tumo07/vehicle-dashboard-cluster/_docx_extract/word/media/image5.png

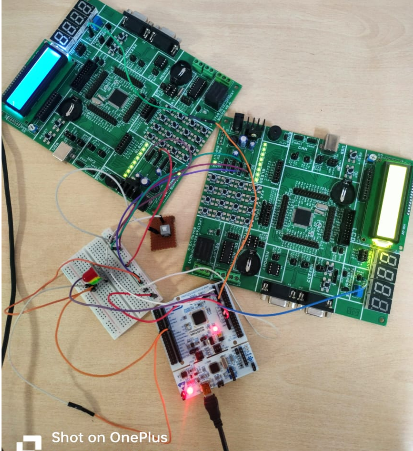
_docx_extract/word/media/image5.png
