tumo07/vehicle-dashboard-cluster/Project_CAN_Bus_Plan.docx

# Smart Vehicle Dashboard Cluster

Complete Implementation Plan (Final - Rev 3)

# 1. Project Overview

This project simulates a real automotive embedded network using the CAN Bus protocol. Four STM32 microcontrollers communicate on a shared 500 kbps CAN bus, each acting as a distinct Electronic Control Unit (ECU). A Qt desktop application serves as the digital instrument cluster (HMI), receiving all CAN traffic via a USB-Serial bridge and sending user commands back onto the bus.

This revision incorporates advanced features including Cloud Telemetry (MQTT), Database Logging (SQLite), Reverse Parking Assist (HC-SR04), and a strict MVC Software Architecture for the HMI.

The project is structured as a Monorepo segmented into 5 distinct modules, plus a shared CAN definitions folder. The team of 5 will collaborate using GitHub CODEOWNERS.

# 2. Confirmed Hardware

Component | Details
Main ECU board | STM32F4-Discovery (STM32F407VGT6)
CAN Bridge / Translator | Blue Pill (STM32F103C8T6)
Front BCM | Blue Pill (STM32F103C8T6)
Rear BCM | Blue Pill (STM32F103C8T6)
CAN Transceivers | SN65HVD230 (3.3V) — one per node
CAN Bitrate | 500 kbps (120 Ω bus termination)
PC Interface | USB-Serial adapter (CH340/CP2102)
Trunk Actuator | Servo motor (50 Hz PWM)
Reverse Sensor | HC-SR04 Ultrasonic Sensor
Speed/Fuel Sim | Potentiometers → ADC
Brake Pedal | Physical push-button (PA0)

# 3. Qt Dashboard Architecture (MVC + DB + IoT)

- Repo 1 (qt_dashboard) utilizes an advanced architecture:
- MVC Architecture: SerialManager (Service), VehicleState (Model), VehicleController (Controller), and QML UI (View).
- SQLite Trip Logging: Local DB logging for speed, fuel consumption, and safety events.
- MQTT Cloud Telemetry: Publishes dashboard data to Mosquitto/ThingSpeak for Fleet Management.

# 4. Node Responsibilities

## 4.1 Node 0x01 — STM32F4-Discovery (Main MCU)

Role: Central sensor broadcaster, blink-tick master, error aggregator.

- PA1 (ADC1 CH1): Speed potentiometer

- PA2 (ADC1 CH2): Fuel potentiometer

- PA0: Headlight toggle button

- PD12/PD13/PD14: Speed status LEDs

- Broadcasts: 0x100, 0x101, 0x102, 0x130 (Blink Tick)

## 4.2 Node 0x00 — Translator (Blue Pill)

Role: Passive bus sniffer and active command injector.

- UART TX: CAN:ID:DLC:DATA

- UART RX: CMD:ID:DLC:DATA

## 4.3 Node 0x02 — Front BCM (Blue Pill)

Role: Front body actuator control.

- PB0: Headlight, PB1: Washer, PB3: Wiper

- PB4/PB5: Front Left/Right turn signal LEDs

- Toggles turn signals on receiving 0x130 Blink Tick

## 4.4 Node 0x03 — Rear BCM (Blue Pill)

Role: Rear body actuators and Reverse Radar.

- PA6 / PA7: HC-SR04 Echo (TIM3 CH1) / Trigger

- PB0: Brake lights, PB1/PB3: Rear turn signals

- PB6: Trunk servo (TIM4 CH1 PWM)

- Transmits 0x301 (Reverse Distance)

# 5. CAN Message Table

CAN ID | Name | DLC | Data Payload
0x100 | Speed | 2 | Byte0: High, Byte1: Low (uint16)
0x101 | Fuel Level | 1 | Byte0: 0-100% (uint8)
0x102 | Headlight | 1 | Byte0: 0x00 / 0x01
0x130 | Blink Tick | 1 | Byte0: 0x01 (Sync tick)
0x110 | Front Command | 1 | Bit0: Headlight, Bit1: Washer, Bit2: Wiper, Bit3: L-Turn, Bit4: R-Turn
0x120 | Rear Command | 1 | Bit0: L-Turn, Bit1: R-Turn, Bit2: Trunk Open, Bit3: Trunk Close
0x200 | Front Status | 2 | Actuator states
0x300 | Rear Status | 2 | Actuator states + Trunk pos
0x301 | Reverse Radar | 2 | Byte0: High, Byte1: Low (Distance in cm)
0x700 | System Error | 3 | Byte0: Source Node, Byte1: Error Code, Byte2: Fault Bitmask
