tumo07/vehicle-dashboard-cluster/front_bcm_firmware/Bao_Cao_Thuyet_Trinh_Front_BCM_Nguyen_Quoc_Dat.pptx

TRƯỜNG ĐẠI HỌC FPT TP.HCM — KHOA KỸ THUẬT Ô TÔ & KHOA HỌC MÁY TÍNH
THIẾT KẾ VÀ HIỆN THỰC HÓA PHÂN HỆ FRONT BCM
Kiến trúc Vi điều khiển kép (Dual-MCU) trên nền tảng Mạng CAN Bus v3.0 Coordinator
• Sinh viên thực hiện: Nguyễn Quốc Đạt — MSSV: FMS00045 (Kỹ sư Phân hệ Front BCM)
• Đề tài: Smart Vehicle Dashboard Cluster Simulator (Nhóm 2 — Lớp M1.2510.E0)
• Giảng viên hướng dẫn: ThS. Phạm Toàn Văn Võ

## Slide 2

FRONT BCM FIRMWARE | SOFTWARE DESIGN

1. TỔNG QUAN VÀ VỊ TRÍ TRONG KIẾN TRÚC PHÂN VÙNG ZONAL E/E

VỊ TRÍ CHIẾN LƯỢC: SMART ZONAL HUB

• Xu hướng Zonal Architecture:
Chuyển dịch từ phân tán theo chức năng sang phân vùng không gian. Front BCM đặt tại khoang động cơ/đầu xe.
• Gom cụm tải & Cảm biến:
Quản lý trực tiếp hệ thống đèn pha, sương mù, DRL, mô-tơ gạt mưa, bơm nước rửa kính, cảm biến mưa quang học và chiết áp Dimmer.
• Tối ưu hóa Dây dẫn (Wiring Harness):
Thay vì kéo hàng chục dây công suất về táp-lô, chỉ duy trì 01 tuyến CAN Bus vi sai 2 dây (CAN_H, CAN_L) kết nối với Central Coordinator ECU.

YÊU CẦU KỸ THUẬT CỐT LÕI (REQUIREMENTS)

1. Thời gian thực khắt khe (Hard Real-Time):
- Độ trễ phản hồi tại biên: < 20 ms.
- Độ trễ toàn trình (End-to-End) đến HMI: < 45 ms.
2. Kháng nghẽn băng thông (Anti-Bottleneck):
- Không làm tràn bộ đệm UART (115200 bps) khi mạng CAN (500 kbps) chạy tải đỉnh.
3. An toàn chức năng (Functional Safety ISO 26262):
- Cơ chế Khóa lỗi cứng (Latched Fault) bảo vệ cháy bơm.
- Tự chẩn đoán phím kẹt vật lý sinh mã DTC chuẩn SAE J2012.

## Slide 3

FRONT BCM FIRMWARE | SOFTWARE DESIGN

2. KIẾN TRÚC PHẦN CỨNG VI ĐIỀU KHIỂN KÉP (DUAL-MCU ARCHITECTURE)

TRANSLATOR NODE — STM32F103C8T6

• Vai trò: Dedicated Gateway (Lớp mạng)
• Thông số: ARM Cortex-M3 @ 72 MHz, 64KB Flash, 20KB SRAM.
• Tác vụ đảm nhận:
- Giao tiếp trực tiếp trục CAN Bus 500 kbps qua bxCAN1.
- Bộ lọc phần cứng (Hardware ID-Mask Filter).
- Xử lý ngắt 100% (Interrupt-Driven) FIFO0 & UART.
- Thuật toán Change-Detection (Shadow Copies) lọc rác.
- Bộ giám sát Timeout 25ms chống trôi khung UART.

ACTUATOR NODE — STM32F411VET6

• Vai trò: Real-Time Actuator & Logic (Lớp ứng dụng)
• Thông số: ARM Cortex-M4F @ 96 MHz, 512KB Flash, 128KB SRAM.
• Tác vụ đảm nhận:
- Đọc ADC liên tục bằng phần cứng DMA (Mưa PA0, Dimmer PC1).
- Xuất 4 kênh PWM: Servo gạt mưa (TIM2), Bơm nước (TIM3), Pha/Cos (TIM4).
- Máy trạng thái gạt mưa 5 chế độ & An toàn bơm nước cạn.
- Chống xung đột quang học đèn và tự động bật đèn sương mù.
- Giám sát Watchdog kẹt nút cơ học > 1.5s sinh mã DTC.

## Slide 4

FRONT BCM FIRMWARE | SOFTWARE DESIGN

3. MA TRẬN BẢN TIN CAN BUS V3.0 CỦA PHÂN HỆ FRONT BCM

Tên Định Danh CAN | CAN ID | Hướng Truyền | DLC | Ý Nghĩa Tải Dữ Liệu (Payload Specification)
CAN_ID_EXEC_FRONT_LIGHTS | 0x200 | Central -> Front | 2 | Byte0: Bitmask đèn (DRL/Cos/Pha/Fog) | Byte1: Độ sáng PWM 0-100%
CAN_ID_EXEC_FRONT_WIPERS | 0x201 | Central -> Front | 2 | Byte0: CmdWiper_t (OFF/INT/SLOW/NORM/FAST/AUTO) | Byte1: Bơm nước
CAN_ID_EXEC_FRONT_TURN | 0x202 | Central -> Front | 1 | Byte0: Bitmask vũ trang xi-nhan trước (Trái, Phải, Hazard)
CAN_ID_BLINK_TICK | 0x130 | Central -> All | 1 | Byte0: 0x01 — Nhịp đồng hồ chớp 1 Hz toàn cục phát mỗi 500 ms
CAN_ID_REPORT_FRONT_STATUS | 0x400 | Front -> Central | 3 | Byte0: FrontActuatorFlags_t | Byte1: WiperMode | Byte2: Health mô-tơ
CAN_ID_REPORT_FRONT_SENSORS | 0x401 | Front -> Central | 2 | Byte0: Cảm biến mưa % (ADC) | Byte1: Mức nước rửa kính % (Phao PE9)
CAN_ID_FAULT_FRONT_BCM | 0x500 | Front -> Central | 5 | Byte0: Severity | Byte1-2: Mã DTC 16-bit | Byte3: Counter | Byte4: ErrCode

## Slide 5

FRONT BCM FIRMWARE | SOFTWARE DESIGN

4. GIAO THỨC UART NỘI BỘ & GIẢI THUẬT CHỐNG TRÔI KHUNG (ANTI-DESYNC)

CẤU TRÚC KHUNG TRUYỀN ĐỒNG BỘ 5-BYTE

• Định dạng khung (F103 -> F411):
[0xAA] [CMD_ID] [DATA_0] [DATA_1] [CHECKSUM]
• Thuật toán Checksum tuyến tính:
Checksum = (uint8_t)(CMD_ID + DATA_0 + DATA_1);
Gói tin sai lệch Checksum bị hủy ngay tại tầng ngắt.
• Phân loại lệnh điều khiển:
- 0x01: Điều khiển đèn (Mask + Brightness)
- 0x02: Gạt mưa & Rửa kính (Mode + Washer)
- 0x03: Xi-nhan vũ trang (Turn Arm)
- 0x04: Nhịp đồng hồ chớp Blink Tick (0x130)

GIẢI THUẬT TIMEOUT 25MS CHỐNG TRÔI KHUNG

• Vấn đề kinh điển của UART: Desynchronization
Nếu mất 1 byte do nhiễu, các gói tin tiếp theo sẽ bị xô lệch vĩnh viễn do MCU lấy nhầm Data làm Start Byte.
• Giải pháp: Inter-Byte Software Watchdog 25ms
uint32_t current_time = HAL_GetTick();
if (current_time - last_rx_time > 25) {
rx_index = 0; // Tự động Reset bộ đệm
}
last_rx_time = current_time;
• Tự giải phóng lỗi phần cứng Overrun:
if (__HAL_UART_GET_FLAG(pUart, UART_FLAG_ORE)) {
__HAL_UART_CLEAR_OREFLAG(pUart);
}

## Slide 6

FRONT BCM FIRMWARE | SOFTWARE DESIGN

5. TRANSLATOR NODE (F103) — THUẬT TOÁN CHANGE-DETECTION (SHADOW COPIES)

BÀI TOÁN NGHẼN CỔ CHAI BĂNG THÔNG

• Xung đột tốc độ truyền dẫn:
- Mạng CAN Bus xe: 500 kbps.
- Đường truyền UART nội bộ: 115200 bps.
• Rủi ro nghẽn mạch (Bus Overrun):
Central ECU phát chu kỳ liên tục các lệnh điều khiển (kể cả khi không có thay đổi). Nếu F103 đẩy mù quáng xuống UART, bộ đệm F411 sẽ bị nghẽn và tràn dữ liệu lập tức.
• Đích đến giải thuật:
Chỉ chuyển tiếp xuống F411 khi và chỉ khi có sự thay đổi trạng thái (Delta Change Only)!

HIỆN THỰC THUẬT TOÁN BẰNG SHADOW COPIES

/* Code thực tế trong file RX_data_CAN.c */
static uint8_t prev_light_mask = 0xFF;
static uint8_t prev_light_brightness = 0xFF;
static void Forward_If_Changed(uint8_t cmdId,
uint8_t d0, uint8_t d1, uint8_t *prev0, uint8_t *prev1) {
// So sánh dữ liệu mới với bản sao bóng
if (d0 == *prev0 && d1 == *prev1) return; // BỎ QUA
*prev0 = d0; *prev1 = d1; // Cập nhật Shadow copy
uint8_t pkt[5] = {0xAA, cmdId, d0, d1, cks};
HAL_UART_Transmit(&huart1, pkt, 5, 10);
}
-> Giảm > 80% tải giao tiếp UART khi xe chạy ổn định!

## Slide 7

FRONT BCM FIRMWARE | SOFTWARE DESIGN

6. ACTUATOR NODE (F411) — HỆ THỐNG GẠT MƯA & KHÓA LỖI LATCHED FAULT

ĐIỀU KHIỂN GẠT MƯA TỰ ĐỘNG THÍCH ỨNG

• 5 Chế độ gạt nước (wiper.c):
OFF, INTERMITTENT (INT), SLOW, NORMAL, FAST, AUTO.
• Đọc ADC Cảm biến mưa ngầm định bằng DMA:
DMA2 Stream0 tự động cập nhật PA0 vào RAM không tốn chu kỳ CPU.
• Thuật toán trễ phân cấp (Hysteresis AUTO Mode):
- ADC > 3000: Trời khô -> Dừng gạt (1000 µs)
- 2400 - 3000: Mưa nhỏ (30%) -> Quét chậm (1800ms)
- 1800 - 2400: Mưa vừa (60%) -> Quét vừa (1200ms)
- ADC <= 1800: Mưa to (100%) -> Quét liên tục (600ms)

CƠ CHẾ KHÓA LỖI CỨNG BẢO VỆ BƠM (DTC B1012)

• Nguy cơ kỹ thuật:
Mô-tơ bơm nước rửa kính dễ cháy hỏng cuộn dây nếu chạy cạn không tải.
• Lọc nhiễu sóng nước Debounce 300ms:
Loại trừ báo động giả khi xe dằn xóc làm rung phao PE9.
• Triết lý An toàn chức năng Non-Recoverable:
- Khi xác nhận cạn nước: Bật is_water_fault_latched = 1.
- Dập tắt xung PWM bơm nước (TIM3_CH1 = 0) ngay lập tức.
- Phát mã chẩn đoán DTC_B1012 lên Central ECU.
- Bơm bị KHÓA CỨNG VĨNH VIỄN trong RAM cho đến khi kỹ thuật viên ngắt nguồn / Reset vi điều khiển!

## Slide 8

FRONT BCM FIRMWARE | SOFTWARE DESIGN

7. ACTUATOR NODE (F411) — HỆ THỐNG ĐÈN & AN TOÀN QUANG HỌC

ĐIỀU BIẾN ĐỘ SÁNG PWM & SÀN BẢO VỆ

• Điều khiển độ sáng Đèn pha (Dimmer):
- Đọc điện áp chiết áp PC1 qua kênh ADC1_IN11 (Rank 2 DMA).
- Xuất PWM tần số cao (1 kHz) trên Timer 4 CH2 (PB7) và CH3 (PB8).
• Thuật toán Giới hạn Sàn an toàn (20% Minimum Floor):
uint8_t pct = (uint8_t)((raw * 100) / 4095);
if (pct < 20) pct = 20; // Chống tắt lịm
Ngăn chặn việc vô tình vặn biến trở về 0 làm tắt ngấm đèn pha trong đêm gây nguy hiểm cho xe.

TRIỆT TIÊU ĐIỂM MÙ & AUTO FOG OVERRIDE

1. Quy tắc Triệt tiêu Điểm mù (Blind-Spot Mitigation):
Theo tiêu chuẩn chiếu sáng an toàn xe cơ giới, khi bật Pha (High Beam), đèn Cos (Low Beam) bắt buộc phải sáng đồng thời để giữ vùng sáng sát đầu xe:
if (is_high_beam_selected) {
is_pha_active = 1;
is_cos_active = 1; // BẮT BUỘC GIỮ COS SÁNG!
}
2. Tự động kích hoạt Đèn sương mù (Auto Fog Override):
Khi cảm biến mưa ghi nhận lượng mưa > 0%:
if (Get_RainSensor_Percent() > 0) is_fog_on = 1;
Hệ thống tự động bật đèn gầm PE12 hỗ trợ người lái trong thời tiết xấu.

## Slide 9

FRONT BCM FIRMWARE | SOFTWARE DESIGN

8. HỆ THỐNG TỰ CHẨN ĐOÁN KẸT PHÍM VẬT LÝ & BÁO CÁO MÃ LỖI DTC

Chân GPIO Giám Sát | Sự Cố Kẹt Cơ Học / Chập GND | Mã DTC (SAE J2012) | Mức Nghiêm Trọng | Mã Lỗi Thu Gọn
PB0 (BTN_TurnLeft) | Kẹt công tắc xi-nhan Trái > 1.5s | DTC_B1030 (0x1030) | DTC_SEVERITY_ERROR | ERR_ACTUATOR_STALL (0x05)
PB1 (BTN_TurnRight) | Kẹt công tắc xi-nhan Phải > 1.5s | DTC_B1031 (0x1031) | DTC_SEVERITY_ERROR | ERR_ACTUATOR_STALL (0x05)
GPIOE (BTN_WiperMode) | Kẹt công tắc đổi chế độ gạt nước > 1.5s | DTC_B1010 (0x1010) | DTC_SEVERITY_ERROR | ERR_WIPER_STALL (0x06)
GPIOE (BTN_CosLamp) | Kẹt công tắc đèn chiếu gần > 1.5s | DTC_B1001 (0x1001) | DTC_SEVERITY_ERROR | ERR_ACTUATOR_STALL (0x05)
GPIOE (BTN_HeadLamp) | Kẹt công tắc đèn chiếu xa > 1.5s | DTC_B1002 (0x1002) | DTC_SEVERITY_ERROR | ERR_ACTUATOR_STALL (0x05)
GPIOE (BTN_FogLamp) | Kẹt công tắc đèn sương mù > 1.5s | DTC_B1004 (0x1004) | DTC_SEVERITY_ERROR | ERR_ACTUATOR_STALL (0x05)

## Slide 10

FRONT BCM FIRMWARE | SOFTWARE DESIGN

9. KẾT QUẢ ĐO KIỂM THỰC NGHIỆM VÀ ĐÁNH GIÁ CHỈ SỐ KỸ THUẬT

ĐỘ TRỄ PHẢN HỒI BIÊN

• Kết quả đo Logic Analyzer:
1. Lọc chống rung phím: 30.0 ms
2. Đóng gói UART F411: 0.43 ms
3. Định tuyến F103: 0.12 ms
4. Chiếm bus CAN: 0.26 ms
-> ĐỘ TRỄ TẠI BIÊN: 30.81 ms
-> ĐỘ TRỄ TOÀN TRÌNH: 33.8 ms
Vượt xa ngưỡng tiêu chuẩn ô tô (< 45 ms)!

KIỂM THỬ TIÊM LỖI (FAULT INJECTION)

• Thử nghiệm 1: Cạn nước rửa kính
Rút phao PE9 -> Đúng 300ms sau dập tắt PWM bơm về 0, phát DTC B1012, bơm khóa cứng chính xác 100%.
• Thử nghiệm 2: Nhiễu đứt cáp UART
Ngắt cáp 100ms -> Cơ chế Timeout 25ms tự xóa byte rác, khôi phục đồng bộ hoàn hảo.
• Thử nghiệm 3: Kẹt phím đèn
Đè nút > 1.5s -> Sáng LED lỗi PE7, bắn CAN 0x500 phát sinh Banner đỏ trên Qt Dashboard.

TÀI NGUYÊN & TẢI CPU

• Translator Node (F103):
- Flash: 14.2 KB (22.1%)
- SRAM: 2.8 KB (14.0%)
- Tải CPU: < 4.5% (Ngắt 100%)
• Actuator Node (F411):
- Flash: 28.6 KB (5.5%)
- SRAM: 6.4 KB (5.0%)
- Tải CPU: < 8.2% (DMA hỗ trợ)
-> Hệ thống hoạt động mát mẻ, ổn định liên tục sau 100,000 khung truyền không rớt gói!

## Slide 11

FRONT BCM FIRMWARE | SOFTWARE DESIGN

10. KẾT LUẬN ĐÓNG GÓP KỸ THUẬT CỦA PHÂN HỆ FRONT BCM

ĐÓNG GÓP CỐT LÕI CỦA KỸ SƯ NGUYỄN QUỐC ĐẠT

1. Kiến trúc Dual-MCU cách ly an toàn:
Tách biệt lớp mạng CAN tốc độ cao và lớp chấp hành phần cứng, loại trừ rủi ro sập bus CAN do xung ngược.
2. Sáng tạo giải thuật Change-Detection:
Dùng Shadow Copies triệt tiêu > 80% tải giao tiếp UART dư thừa.
3. Thiết kế giao thức UART tự phục hồi (Self-Healing):
Khắc phục hoàn toàn lỗi trôi khung với Timeout 25ms và giải phóng cờ tràn ORE.
4. Hiện thực hóa chuẩn an toàn ô tô (Functional Safety):
Khóa lỗi cứng Latched Fault cạn nước (DTC B1012), triệt tiêu điểm mù Pha/Cos, tự chẩn đoán kẹt nút chuẩn SAE J2012.

HƯỚNG PHÁT TRIỂN & LỜI CẢM ƠN

• Hướng phát triển nâng cao:
- Chuyển đổi sang kiến trúc AUTOSAR Classic (tách tầng MCAL, BSW, RTE, SWC).
- Nâng cấp mạng CAN-FD (5 Mbps, 64-byte payload) phục vụ tích hợp Radar mmWave.
━━━━━━━━━━━━━━━━━━━━━━━━━━━━━
XIN TRÂN TRỌNG CẢM ƠN QUÝ THẦY CÔ TRONG HỘI ĐỒNG BẢO VỆ ĐÃ LẮNG NGHE!
RẤT MONG NHẬN ĐƯỢC NHẬN XÉT VÀ CÂU HỎI TỪ HỘI ĐỒNG (Q&A).
