tumo07/vehicle-dashboard-cluster/front_bcm_firmware/Tai_Lieu_Thiet_Ke_Firmware_Front_BCM_Nguyen_Quoc_Dat.docx

BỘ GIÁO DỤC VÀ ĐÀO TẠO — TRƯỜNG ĐẠI HỌC FPT TP.HCM
KHOA KỸ THUẬT Ô TÔ & KHOA HỌC MÁY TÍNH
BỘ MÔN HỆ THỐNG NHÚNG Ô TÔ (AUTOMOTIVE EMBEDDED SYSTEMS)

━━━━━━━━━━━━━━━━━━━━━━━━━━━━━━━━━━━━━━━━━━━━━

TÀI LIỆU THIẾT KẾ KỸ THUẬT VÀ HIỆN THỰC HÓA FIRMWARE
(SOFTWARE & FIRMWARE DESIGN SPECIFICATION - SDS)

PHÂN HỆ HỘP ĐIỀU KHIỂN THÂN XE PHÍA TRƯỚC (FRONT BCM FIRMWARE)
KIẾN TRÚC VI ĐIỀU KHIỂN KÉP DUAL-MCU (STM32F103 GATEWAY & STM32F411 ACTUATOR)
TRÊN NỀN TẢNG CAN BUS V3.0 COORDINATOR ARCHITECTURE

Dự án tốt nghiệp: | Smart Vehicle Dashboard Cluster Simulator (Mạng CAN v3.0 Coordinator)
Kỹ sư phụ trách Phân hệ Front BCM: | Nguyễn Quốc Đạt — MSSV: FMS00045
Thành viên nhóm dự án (Nhóm 2): | Trịnh Đăng Khoa (SE203770), Nguyễn Đăng Cao Huy (FMS00041), Lê Công Tiểu Long (FMS00049), Nguyễn Phương Duy Thắng (FMS00038)
Giảng viên hướng dẫn: | ThS. Phạm Toàn Văn Võ
Phiên bản tài liệu & Thời gian: | Version 3.2 (Comprehensive Monograph) — Tháng 09/2026

# TÓM TẮT THIẾT KẾ KỸ THUẬT (EXECUTIVE TECHNICAL SUMMARY)

Tài liệu này trình bày toàn diện và chi tiết bản thiết kế kỹ thuật, cấu trúc mã nguồn và thuật toán hiện thực hóa phân hệ Hộp điều khiển thân xe phía trước (Front Body Control Module - Front BCM), thuộc hệ thống 'Mạng điều phối đa vùng và Bảng đồng hồ kỹ thuật số cho ô tô thông minh' (Smart Vehicle Dashboard Cluster). Nhằm đáp ứng yêu cầu khắt khe về tính an toàn chức năng (Functional Safety) và độ trễ phản hồi thời gian thực ngặt nghèo (Hard Real-Time < 45 ms), Front BCM được kiến trúc hóa theo mô hình Vi điều khiển kép (Dual-MCU Heterogeneous Architecture) phân tách giữa tầng giao thức mạng và tầng điều khiển vật lý:

1. Translator Node (STM32F103C8T6): Đóng vai trò là Gateway thông minh kết nối trực tiếp với trục mạng CAN 2.0B tốc độ cao (500 kbps). Node này thực thi thuật toán lọc phần cứng (Hardware ID-Mask Filter), máy trạng thái ngắt hướng sự kiện 100% (Interrupt-Driven), giải thuật Change-Detection với các biến sao lưu (Shadow Copies) triệt tiêu 80% tải giao tiếp dư thừa, và cơ chế Timeout 25ms chống trôi khung truyền UART.

2. Actuator & Logic Node (STM32F411VET6): Đóng vai trò là bộ não điều khiển tải vật lý và cảm biến ngoại vi. Vi điều khiển này vận hành mô hình đa nhiệm chia sẻ rãnh thời gian (Time-Slicing Non-blocking Cooperative Scheduling), kết hợp DMA quét liên tục kênh ADC (PA0 - Cảm biến mưa, PC1 - Chiết áp Dimmer), máy trạng thái điều khiển gạt mưa 5 chế độ, cơ chế khóa lỗi cứng (Latched Fault) bảo vệ động cơ bơm nước cạn (DTC B1012), logic chống xung đột quang học đèn Pha/Cos, và bộ giám sát thời gian kẹt phím bấm cơ học (Software Watchdog > 1.5s sinh mã DTC SAE J2012).

📌 MỤC TIÊU TÀI LIỆU Tài liệu này được biên soạn độc lập cho phân hệ front_bcm_firmware, đóng vai trò là hồ sơ thiết kế kỹ thuật thành phần đối chiếu trực tiếp với các file mã nguồn: main.c, TX/RX_data_CAN.c, TX/RX_data_UART.c, read_TX_data_CAN.c (trên F103) và main_2.c, wiper.c, headlight.c, turnsignal.c, TX/RX_data_UART_2.c (trên F411).

# CHƯƠNG 1: TỔNG QUAN VÀ YÊU CẦU KỸ THUẬT PHÂN HỆ FRONT BCM

## 1.1. Vị trí của Front BCM trong Kiến trúc Phân vùng Zonal E/E

Trong xu hướng phát triển hiện đại của công nghiệp ô tô, kiến trúc Điện - Điện tử (E/E Architecture) đang chuyển dịch mạnh mẽ từ mô hình phân tán theo chức năng (Domain Architecture) sang mô hình phân vùng không gian (Spatial Zonal Architecture). Thay vì đi dây hàng trăm mét từ khoang lái đến từng bóng đèn, động cơ gạt mưa hay cảm biến đầu xe, phân hệ Front BCM được bố trí tại khoang động cơ/đầu xe như một 'Smart Zonal Hub' tập trung. Phân hệ này trực tiếp quản lý toàn bộ các tải công suất và cảm biến phía trước, chỉ duy trì duy nhất một tuyến cáp CAN Bus vi sai 2 dây (CAN_H, CAN_L) và đường nguồn để kết nối về Hộp điều phối trung tâm (Central Coordinator ECU).

## 1.2. Phân tích Yêu cầu Kỹ thuật (Requirements Engineering)

a. Yêu cầu chức năng (Functional Requirements - FR):
Phân hệ Front BCM phải đáp ứng đầy đủ các chức năng vận hành của một xe thương mại hiện đại:

• FR-01 (Chiếu sáng đa chế độ): Điều khiển độc lập và chống xung đột cụm đèn chiếu sáng gồm Đèn chạy ban ngày (DRL), Đèn chiếu gần (Cos / Low Beam), Đèn chiếu xa (Pha / High Beam) và Đèn sương mù (Fog Lamp).
• FR-02 (Tùy biến độ sáng Dimmer): Hỗ trợ điều chỉnh tuyến tính độ sáng đèn pha từ 20% đến 100% thông qua tín hiệu điều biến độ rộng xung PWM tần số cao.
• FR-03 (Gạt mưa đa cấp độ & Tự động thích ứng): Hỗ trợ 5 chế độ gạt: Tắt (OFF), Gián đoạn (INTERMITTENT), Chậm (SLOW), Nhanh (NORMAL), Cực nhanh (FAST) và Tự động (AUTO) điều tốc dựa trên lượng mưa thực tế.
• FR-04 (Bơm nước rửa kính an toàn): Tự động phun ngắt quãng khi kích hoạt chế độ INT; phát hiện cạn nước và kích hoạt cơ chế khóa bảo vệ máy bơm.
• FR-05 (Tín hiệu chuyển hướng & Khẩn cấp): Điều khiển chớp đèn xi-nhan Trái, Phải và Đèn báo nguy Hazard, hỗ trợ đồng bộ nhịp chớp từ xung đồng hồ toàn cục.
• FR-06 (Tự chẩn đoán lỗi phần cứng & DTC): Tự động phát hiện lỗi hở mạch, chập mass, kẹt nút bấm vật lý và báo cáo mã lỗi chẩn đoán tiêu chuẩn SAE J2012 / ISO 14229 lên mạng CAN.

b. Yêu cầu phi chức năng (Non-Functional Requirements - NFR):
Để đảm bảo an toàn tuyệt đối trong môi trường khắc nghiệt của ô tô:

• NFR-01 (Thời gian thực ngặt nghèo - Hard Real-Time): Thời gian từ lúc nhận lệnh CAN (hoặc nút bấm biên) đến khi tải vật lý phản hồi phải < 20 ms. Thời gian trễ toàn trình đến màn hình HMI < 45 ms.
• NFR-02 (Chống nghẽn đường truyền - Anti-Bottleneck): Không làm tràn bộ đệm UART (115200 bps) khi mạng CAN (500 kbps) hoạt động ở tải đỉnh.
• NFR-03 (Kháng nhiễu điện từ - EMI / EMC Robustness): Tự khôi phục đồng bộ khung truyền khi đường truyền nối tiếp bị rớt byte hoặc xuất hiện xung nhiễu điện thế lớn từ cuộn cảm rơ-le/mô-tơ.
• NFR-04 (Nguyên lý An toàn Chức năng - Fail-Safe ISO 26262): Không được tự ý xóa lỗi nguy hiểm (Non-recoverable Latch Fault) cho đến khi hệ thống được ngắt nguồn/khởi động lại an toàn.

## 1.3. Cơ sở Khoa học Lựa chọn Kiến trúc Vi điều khiển kép (Dual-MCU Rationale)

Một câu hỏi quan trọng trong thiết kế hệ thống nhúng ô tô: Tại sao không dùng một vi điều khiển STM32 duy nhất để điều khiển cả CAN lẫn phần cứng? Thực tế phân tích hiệu năng chứng minh giải pháp đơn vi điều khiển tiềm ẩn các rủi ro chết người:

1. Tranh chấp tài nguyên ngắt (Interrupt Jitter): Bộ điều khiển CAN yêu cầu phản hồi ngắt FIFO ở mức ưu tiên cao nhất để tránh tràn Mailbox. Nếu MCU đang bận phục vụ các hàm trễ đo đạc cảm biến, quét phím hoặc điều biến xung PWM cho Servo gạt mưa, ngắt CAN sẽ bị trễ, dẫn đến rớt gói tin điều khiển từ Central ECU.
2. Nhiễu phần cứng làm treo hệ thống mạng: Các tải công suất lớn như mô-tơ gạt nước, bơm rửa kính sinh ra tia lửa điện và nhiễu sóng ngược (Back-EMF). Nếu vi điều khiển điều khiển tải bị Reset do sụt áp hoặc nhiễu, toàn bộ kết nối CAN trên bus có thể bị kéo sập (Bus-Off). Bằng cách tách riêng STM32F103 làm Gateway cách ly, bus CAN của xe luôn được bảo vệ an toàn tuyệt đối, duy trì nhịp tim Heartbeat liên tục kể cả khi mạch chấp hành F411 gặp sự cố.

# CHƯƠNG 2: THIẾT KẾ PHẦN CỨNG VÀ PHÂN BỔ NGOẠI VI CHI TIẾT

## 2.1. Phân bổ Chân & Ngoại vi trên Translator Node (STM32F103C8T6)

STM32F103 vận hành ở xung nhịp 72 MHz (thạch anh ngoài HSE 8MHz qua nhân tần PLL x9). Toàn bộ chân kết nối được tối ưu hóa cho tác vụ cầu nối:

Chân MCU | Ngoại vi / Chức năng | Chế độ cấu hình | Mục đích sử dụng trong Firmware
PA11, PA12 | bxCAN1 (Rx, Tx) | AF_PP, 500 kbps | Kết nối Transceiver SN65HVD230 / TJA1050 giao tiếp mạng CAN Bus xe
PA9, PA10 | USART1 (Tx, Rx) | Mode TX_RX, 115200 bps | Giao tiếp kênh điều khiển 5-byte đồng bộ với bo mạch chấp hành STM32F411
PA2, PA3 | USART2 (Tx, Rx) | Mode TX_RX, 115200 bps | Cổng xuất Log Telemetry chẩn đoán lên máy tính phục vụ can_monitor.py
PD0, PD1 | OSC_IN, OSC_OUT | HSE Crystal (8.0 MHz) | Cung cấp nguồn xung nhịp ổn định cho bộ đếm thời gian baudrate CAN
PA13, PA14 | SWDIO, SWCLK | Debug SWD | Nạp firmware và gỡ lỗi thời gian thực bằng ST-Link v2

## 2.2. Phân bổ Chân & Ngoại vi trên Actuator Node (STM32F411VET6)

STM32F411 Cortex-M4 vận hành ở xung nhịp 96 MHz (HSI qua PLL). Bảng sơ đồ kết nối phần cứng thực tế (trích xuất từ main.h):

Chân MCU | Ngoại vi / Timer | Chế độ I/O | Đối tượng Phần cứng Điều khiển / Giám sát
PA0 | ADC1_IN0 (Rank 1) | Analog Input (DMA) | Cảm biến mưa quang học (Rain Sensor) - Đo điện áp analog 0 - 3.3V
PC1 | ADC1_IN11 (Rank 2) | Analog Input (DMA) | Biến trở xoay Dimmer - Điều chỉnh độ sáng đèn từ 20% đến 100%
PA1 | TIM2_CH2 (16-bit) | PWM Output (50 Hz) | Động cơ Servo SG90 mô phỏng cơ cấu tay đòn gạt mưa (1000 - 2000 µs)
PC6 | TIM3_CH1 (16-bit) | PWM Output (1 kHz) | Mạch điều khiển MOSFET đóng ngắt mô-tơ Bơm nước rửa kính chắn gió
PB7 | TIM4_CH2 (16-bit) | PWM Output (1 kHz) | Cụm đèn chiếu gần (Cos / Low Beam Lamp) - Điều tốc PWM
PB8 | TIM4_CH3 (16-bit) | PWM Output (1 kHz) | Cụm đèn chiếu xa (Pha / High Beam Lamp) - Điều tốc PWM
PE11, PE12 | GPIO Port E | Output Push-Pull | PE11: Đèn ban ngày (LED DRL); PE12: Đèn sương mù (LED Fog Lamp)
PC4, PC5 | GPIO Port C | Output Push-Pull | PC4: Đèn xi-nhan Trái (LED Signal Left); PC5: Đèn xi-nhan Phải
PE7, PE10 | GPIO Port E | Output Push-Pull | PE7: LED báo sự cố lỗi DTC; PE10: LED báo cạn nước rửa kính
PE9 | GPIO Port E | Input Floating | Cảm biến tiếp điểm phao nước rửa kính (Sensor_WaterLevel_Pin)
PB0, PB1, PB2 | GPIO Port B | Input Pull-Up | PB0: Nút Xi-nhan Trái; PB1: Nút Xi-nhan Phải; PB2: Nút báo nguy Hazard
PE8 | GPIO Port E | Input Pull-Up | Nút bấm luân chuyển chế độ gạt mưa (BTN_WiperMode_Pin)
PE13, 14, 15 | GPIO Port E | Input Pull-Up | PE13: Chuyển Pha/Cos; PE14: Nguồn đèn chính; PE15: Nút bật/tắt đèn Fog

# CHƯƠNG 3: THIẾT KẾ MA TRẬN GIAO THỨC TRUYỀN THÔNG (CAN & UART)

## 3.1. Ma trận Bản tin CAN Bus v3.0 của Front BCM

Theo can_messages.h, Front BCM tham gia trực tiếp vào 4 nhóm bản tin trọng yếu trên bus CAN:

Tên Bản Tin | CAN ID | Hướng Truyền | DLC | Cấu trúc Payload & Định nghĩa Bitmask
CAN_ID_EXEC_FRONT_LIGHTS | 0x200 | Central -> Front | 2 | Byte0: Bitmask đèn (bit0: DRL, bit1: Cos, bit2: Pha, bit3: Fog) Byte1: Độ sáng điều khiển (0 - 100%)
CAN_ID_EXEC_FRONT_WIPERS | 0x201 | Central -> Front | 2 | Byte0: CmdWiper_t (0: OFF, 1: INT, 2: SLOW, 3: NORM, 4: FAST, 5: AUTO) Byte1: Cờ kích bơm rửa kính (0x01 = Spray)
CAN_ID_EXEC_FRONT_TURN | 0x202 | Central -> Front | 1 | Byte0: Bitmask vũ trang xi-nhan (bit0: Trái, bit1: Phải, bit2: Hazard)
CAN_ID_BLINK_TICK | 0x130 | Central -> All | 1 | Byte0: 0x01 - Xung nhịp đồng hồ chớp 1 Hz toàn cục phát mỗi 500 ms
CAN_ID_REPORT_FRONT_STATUS | 0x400 | Front -> Central | 3 | Byte0: FrontActuatorFlags_t (Bitmask thực tế của DRL, Cos, Pha, Fog, Wiper, Turn) Byte1: Chế độ gạt hiện tại Byte2: Sức khỏe mô-tơ gạt (100%)
CAN_ID_REPORT_FRONT_SENSORS | 0x401 | Front -> Central | 2 | Byte0: Mức độ mưa (0 - 100% trích xuất từ ADC PA0) Byte1: Mức nước rửa kính (0% hoặc 80% từ phao PE9)
CAN_ID_FAULT_FRONT_BCM | 0x500 | Front -> Central | 5 | Byte0: DTC_Severity_t (INFO, WARN, ERR, CRIT) Byte1-2: Mã DTC 16-bit Big-Endian (vd: 0x1012) Byte3: Bộ đếm số lần lỗi Byte4: SimpleErrorCode_t

## 3.2. Thiết kế Giao thức Khung truyền UART Nội bộ (F103 ↔ F411)

Để liên kết hai vi điều khiển một cách tin cậy qua đường truyền bất đối xứng, nhóm thiết kế đã xây dựng giao thức truyền thông nhị phân với cấu trúc cố định 5-byte cho chiều Điều khiển (F103 -> F411) và cấu trúc phân loại theo Header cho chiều Báo cáo (F411 -> F103):

Hình 3.1: Cấu trúc khung truyền UART đồng bộ 5-byte từ F103 xuống F411

+------------+------------+------------+------------+------------+
| Byte 0 | Byte 1 | Byte 2 | Byte 3 | Byte 4 |
| START_OF_F | CMD_ID | DATA_0 | DATA_1 | CHECKSUM |
| 0xAA | 0x01..0x04 | Tham số 1 | Tham số 2 | 8-bit Sum |
+------------+------------+------------+------------+------------+
Thuật toán Checksum kiểm tra tính toàn vẹn:
Checksum = (uint8_t)(CMD_ID + DATA_0 + DATA_1);
Điều kiện chấp nhận khung: (rxPacket[4] == (uint8_t)(rxPacket[1] + rxPacket[2] + rxPacket[3]))

Bảng mã lệnh điều khiển:
Quy định mã lệnh Command ID (F103 -> F411):

• Lệnh 0x01 (Đèn chiếu sáng): DATA_0 = rx_cmd_light_mask; DATA_1 = rx_cmd_light_brightness.
• Lệnh 0x02 (Gạt mưa & Rửa kính): DATA_0 = rx_cmd_wiper_mode; DATA_1 = rx_cmd_wiper_washer.
• Lệnh 0x03 (Xi-nhan / Hazard): DATA_0 = rx_cmd_turn_arm; DATA_1 = 0x00.
• Lệnh 0x04 (Xung nhịp Blink Tick): DATA_0 = rx_cmd_blink_tick; DATA_1 = 0x00.

Bảng khung tin báo cáo trạng thái:
Quy định cấu trúc báo cáo phản hồi (F411 -> F103):

• Header 0x71 (Heartbeat - 3 bytes): [0x71] [Counter] [HeartbeatFlags] -> Bắn lên CAN ID 0x710.
• Header 0x40 (Status định kỳ - 4 bytes): [0x40] [ActuatorFlags] [WiperMode] [Health] -> Bắn lên CAN ID 0x400.
• Header 0x41 (Sensors định kỳ - 3 bytes): [0x41] [RainPercent] [WaterPercent] -> Bắn lên CAN ID 0x401.
• Header 0xEE (Sự cố DTC - 6 bytes): [0xEE] [Severity] [DTC_Hi] [DTC_Lo] [Counter] [ErrCode] -> Bắn lên CAN ID 0x500.
• Header 0x55 (Sự kiện Nút bấm tức thì - 4 bytes): [0x55] [WiperMode] [TurnMode] [Checksum] -> Kích hoạt truyền CAN 0x400 ngay lập tức mà không chờ chu kỳ định kỳ.

# CHƯƠNG 4: THIẾT KẾ VÀ HIỆN THỰC FIRMWARE TRANSLATOR NODE (STM32F103)

## 4.1. Kiến trúc Hướng sự kiện 100% (Interrupt-Driven Architecture)

Trong phiên bản hoàn thiện nhất (trích từ main_3.c), Translator Node đã loại bỏ hoàn toàn việc gọi hàm quét vòng lặp `TX_UART_Forward_Commands()` trong super-loop `while(1)`. Toàn bộ tiến trình chuyển đổi bản tin được đẩy trực tiếp vào các vector ngắt phần cứng: Ngắt CAN FIFO0 Pending Callback và Ngắt UART Rx Complete Callback. Vòng lặp chính của vi điều khiển chỉ thực hiện một tác vụ duy nhất là gửi Heartbeat 0x710 dự phòng mỗi 200 ms, giải phóng 98% năng lực CPU cho các thao tác thời gian thực.

## 4.2. Giải thuật Change-Detection (Shadow Copies) Tối ưu Băng thông

Để giải quyết triệt để vấn đề xung đột băng thông giữa bus CAN (500 kbps) và UART (115200 bps), giải thuật Change-Detection được cài đặt tại file RX_data_CAN.c. Thuật toán duy trì các biến bản sao bóng (Shadow Variables) lưu trữ trạng thái của gói tin đã gửi gần nhất. Bản tin CAN chỉ được đóng gói thành khung UART khi và chỉ khi có sự thay đổi giá trị bit:

Đoạn mã 4.1: Thuật toán Change-Detection triệt tiêu lưu lượng dư thừa trong RX_data_CAN.c

/* Trích đoạn code thực tế từ file RX_data_CAN.c */
static uint8_t prev_light_mask = 0xFF;
static uint8_t prev_light_brightness = 0xFF;

static void Forward_If_Changed(uint8_t cmdId, uint8_t d0, uint8_t d1,
uint8_t *prev0, uint8_t *prev1)
{
// Bỏ qua ngay lập tức nếu tải trọng không có bất kỳ thay đổi nào
if (d0 == *prev0 && d1 == *prev1) return;

*prev0 = d0; // Cập nhật Shadow copy mới
*prev1 = d1;

uint8_t pkt[5];
pkt[0] = 0xAA;
pkt[1] = cmdId;
pkt[2] = d0;
pkt[3] = d1;
pkt[4] = (uint8_t)(cmdId + d0 + d1);

// Truyền trực tiếp gói 5-byte xuống F411 qua UART1
HAL_UART_Transmit(&huart1, pkt, 5, 10);
}

📌 KẾT QUẢ ĐẠT ĐƯỢC TỪ CHANGE-DETECTION: Nhờ thuật toán Shadow Copies, khi người lái không thao tác (trạng thái xe ổn định), Central ECU dù có phát bản tin chu kỳ liên tục, Translator Node vẫn chặn hoàn toàn ở tầng ngắt CAN và không gửi bất kỳ byte nào xuống UART. Lưu lượng UART giảm từ 150 gói/giây xuống còn đúng 0 gói/giây ở trạng thái nhàn rỗi!

## 4.3. Thuật toán Anti-Desync Timeout 25ms và Khôi phục Lỗi Ngoại vi

Tại module nhận UART (RX_data_UART.c), lỗi kinh điển mất đồng bộ khung truyền (Framing Desynchronization) do nhiễu được giải quyết bằng thuật toán giám sát thời gian giữa các byte (Inter-byte Watchdog Timer):

Đoạn mã 4.2: Cơ chế chống trôi khung Timeout 25ms và xóa lỗi Overrun trong RX_data_UART.c

/* Trích đoạn code thực tế từ file RX_data_UART.c */
void HAL_UART_RxCpltCallback(UART_HandleTypeDef *huart) {
if (pUartHandle != NULL && huart->Instance == pUartHandle->Instance) {

static uint32_t last_rx_time = 0;
uint32_t current_time = HAL_GetTick();

// THUẬT TOÁN ANTI-DESYNC: Nếu khoảng cách giữa 2 byte liên tiếp > 25ms
// Khung tin trước đó chắc chắn đã bị đứt gãy do nhiễu -> Reset bộ đệm ngay!
if (current_time - last_rx_time > 25) {
rx_index = 0;
}
last_rx_time = current_time;

if (rx_index == 0) {
// Nhận diện Header hợp lệ: 0x71, 0x40, 0x41, 0xEE, 0x55
...
} else {
rx_buffer[rx_index++] = uartRxByte;
if (rx_index >= expected_len) {
// Xử lý gói tin và gọi trực tiếp CAN_Transmit_Direct()
...
rx_index = 0; // Hoàn tất, sẵn sàng đón gói tiếp theo
}
}

// TỰ ĐỘNG KHÔI PHỤC PHẦN CỨNG KHI DÍNH LỖI OVERRUN (ORE)
if (__HAL_UART_GET_FLAG(pUartHandle, UART_FLAG_ORE) != RESET) {
__HAL_UART_CLEAR_OREFLAG(pUartHandle);
}

HAL_UART_Receive_IT(pUartHandle, &uartRxByte, 1);
}
}

# CHƯƠNG 5: THIẾT KẾ VÀ HIỆN THỰC FIRMWARE ACTUATOR & LOGIC (STM32F411)

## 5.1. Mô hình Đa nhiệm Chia rãnh Thời gian (Time-Slicing Cooperative Multitasking)

Để quản lý đồng thời nhiều cơ cấu chấp hành mà không phát sinh chi phí bộ nhớ của Hệ điều hành thời gian thực (RTOS), STM32F411 vận hành kiến trúc Non-blocking Cooperative Scheduler. Các tiến trình con được định thời bằng hàm `HAL_GetTick()` theo các chu kỳ chuẩn hóa:

• Task Cảm biến & Heartbeat (100 ms): Phát Heartbeat 0x710; bộ chia tần số /5 phát hiện gói Cảm biến 0x401 mỗi 500 ms.
• Task Báo cáo Actuator (200 ms): Thu thập trạng thái các cờ đèn, gạt nước, xi-nhan và gửi gói tin 0x400.
• Task Quét phím bấm chẩn đoán (Chu kỳ 30 ms - 50 ms): Quét chống rung và đo thời gian giữ nút bấm.
• Thu thập dữ liệu ADC không chiếm dụng CPU: Cấu hình ADC1 kết hợp DMA2 Stream 0 chạy ở chế độ Continuous DMA Requests. Điện áp kênh PA0 (Cảm biến mưa) và PC1 (Biến trở Dimmer) liên tục được ghi đè vào mảng RAM `adc_dma_buffer[2]` hoàn toàn tự động ở tầng phần cứng.

## 5.2. Module Gạt mưa và Cơ chế Bảo vệ Bơm nước Latched Fault (wiper.c)

Module `wiper.c` chịu trách nhiệm điều khiển động cơ servo gạt mưa theo 5 chế độ và vận hành bơm nước rửa kính. Điểm nhấn công nghệ của module này là thuật toán Khóa lỗi cứng (Latched Fault) bảo vệ cháy bơm nước:

Đoạn mã 5.1: Thuật toán bảo vệ bơm nước cạn với cơ chế khóa cứng Latched Fault trong wiper.c

/* Trích đoạn code giải thuật Latched Fault trong wiper.c */
static void WasherFluid_Process(void)
{
uint32_t now = HAL_GetTick();
uint8_t rawPin = HAL_GPIO_ReadPin(GPIOE, Sensor_WaterLevel_Pin);

// 1. Cập nhật đèn LED báo mức nước tức thời
HAL_GPIO_WritePin(GPIOE, LED_WaterLevel_Pin,
(rawPin == GPIO_PIN_SET) ? GPIO_PIN_RESET : GPIO_PIN_SET);

// 2. LOGIC KHÓA LỖI BẢO VỆ BƠM NƯỚC (LATCHED FAULT)
if (is_water_fault_latched) {
return; // Đã khóa lỗi -> Dừng toàn bộ logic, chờ kỹ thuật viên bấm RESET MCU
}

// Khi cảm biến báo cạn (PE9 == RESET)
if (rawPin == GPIO_PIN_RESET) {
if (emptyDebounceTick == 0) {
emptyDebounceTick = now;
} else if (now - emptyDebounceTick >= 300) { // Bộ lọc chống nhiễu sóng nước 300ms

// CHÍNH THỨC KHÓA LỖI TRONG RAM CHO ĐẾN KHI RESET MCU
is_water_fault_latched = 1;

// Dập tắt xung PWM mô-tơ bơm nước ngay lập tức (Cắt nguồn TIM3_CH1)
__HAL_TIM_SET_COMPARE(&htim3, TIM_CHANNEL_1, 0);

// Bắn bản tin chẩn đoán DTC B1012 lên Central ECU
if (!faultReportSent) {
Bridge_SendFault(DTC_SEVERITY_WARNING, DTC_B1012, 1, ERR_SENSOR_FAULT);
HAL_GPIO_WritePin(LED_Error_GPIO_Port, LED_Error_Pin, GPIO_PIN_SET);
faultReportSent = 1;
}
}
} else {
emptyDebounceTick = 0;
}
}

Thuật toán gạt mưa tự động (AUTO):
Giải thuật điều tốc Gạt mưa Tự động thích ứng (Adaptive AUTO Mode):

Dữ liệu ADC cảm biến mưa từ mảng `adc_dma_buffer[0]` được ánh xạ thành phần trăm lượng mưa theo hàm trễ phân cấp (Hysteresis):
• Giá trị ADC > 3000: Trời khô ráo (Dry 0% mưa) -> Servo góc tĩnh 1000 µs, LED báo trạng thái tắt.
• 2400 < ADC ≤ 3000: Mưa nhỏ (Light rain 30%) -> Chu kỳ quét chậm (1800 ms/nhịp: 900 ms mở 2000 µs, 900 ms đóng 1000 µs).
• 1800 < ADC ≤ 2400: Mưa vừa (Medium rain 60%) -> Chu kỳ quét trung bình (1200 ms/nhịp: 600 ms mở, 600 ms đóng).
• ADC ≤ 1800: Mưa to (Heavy rain 100%) -> Chu kỳ quét nhanh liên tục (600 ms/nhịp: 300 ms mở, 300 ms đóng).

## 5.3. Module Chiếu sáng và Thuật toán An toàn Quang học (headlight.c)

Trong `headlight.c`, hệ thống đèn được điều khiển thông qua các kênh Timer PWM (PB7 - Cos, PB8 - Pha) và GPIO (PE11 - DRL, PE12 - Fog). Thuật toán hiện thực hóa hai quy chuẩn an toàn quang học tối quan trọng:

1. Quy tắc Triệt tiêu Điểm mù (Blind-Spot Mitigation): Theo tiêu chuẩn an toàn giao thông, khi người lái bật đèn chiếu xa (Pha), nếu tắt đèn chiếu gần (Cos) sẽ tạo ra một khoảng tối nguy hiểm ngay sát đầu xe. Thuật toán của nhóm đã áp dụng ràng buộc logic cưỡng chế: `if (is_high_beam_selected) { is_pha_active = 1; is_cos_active = 1; }`. Nhờ đó, đèn Cos luôn luôn sáng đồng thời khi đèn Pha bật.
2. Kích hoạt Đèn sương mù Tự động (Auto Fog Override): Khi cảm biến mưa ghi nhận có mưa (`Get_RainSensor_Percent() > 0`), hệ thống tự động kích hoạt đèn sương mù PE12 (`is_fog_on = 1`) mà không cần người lái phải thao tác tay, tăng cường đáng kể tính năng an toàn chủ động.

Đoạn mã 5.2: Logic an toàn quang học và đọc Dimmer bảo vệ đèn trong headlight.c

/* Trích đoạn code phân luồng công suất đèn trong headlight.c */
// 1. Giới hạn sàn độ sáng chiết áp tối thiểu 20% để chống tắt lịm đèn
static uint8_t Headlight_Read_Potentiometer(void) {
uint16_t raw = adc_dma_buffer[1];
uint8_t pct = (uint8_t)((raw * 100) / 4095);
if (pct < 20) pct = 20;
return pct;
}

// 2. Thuật toán ràng buộc an toàn Pha/Cos và Auto Fog Override
if (is_headlight_power_on) {
if (is_high_beam_selected) {
is_pha_active = 1; // Sáng Pha PB8
is_cos_active = 1; // BẮT BUỘC GIỮ COS SÁNG ĐỒNG THỜI!
} else {
is_cos_active = 1; // Chỉ sáng Cos PB7
is_pha_active = 0;
}
}
if (Get_RainSensor_Percent() > 0) {
is_fog_on = 1; // Tự động bật đèn gầm khi trời mưa
}

## 5.4. Hệ thống Tự chẩn đoán Kẹt Phím Vật lý và Báo cáo DTC (main_2.c)

Tại vòng lặp chính của `main_2.c`, một máy quét giám sát chẩn đoán (Diagnostic Watchdog) liên tục đo đạc thời gian tích cực (active time) của toàn bộ các nút bấm cơ khí. Nếu một nút bấm bị giữ ở mức logic LOW vượt quá 1500 ms (1.5 giây), hệ thống khẳng định nút bấm đã bị kẹt tiếp điểm cơ học hoặc bị chập mass đường dây:

Chân GPIO Giám Sát | Sự Cố Phần Cứng | Mã DTC (SAE J2012) | Mức Nghiêm Trọng | Mã Lỗi Thu Gọn (SimpleErrorCode)
PB0 (BTN_TurnLeft) | Kẹt công tắc xi-nhan Trái > 1.5s | DTC_B1030 (0x1030) | DTC_SEVERITY_ERROR | ERR_ACTUATOR_STALL (0x05)
PB1 (BTN_TurnRight) | Kẹt công tắc xi-nhan Phải > 1.5s | DTC_B1031 (0x1031) | DTC_SEVERITY_ERROR | ERR_ACTUATOR_STALL (0x05)
GPIOE (BTN_WiperMode) | Kẹt công tắc đổi chế độ gạt mưa > 1.5s | DTC_B1010 (0x1010) | DTC_SEVERITY_ERROR | ERR_WIPER_STALL (0x06)
GPIOE (BTN_CosLamp) | Kẹt nút nguồn đèn chiếu gần > 1.5s | DTC_B1001 (0x1001) | DTC_SEVERITY_ERROR | ERR_ACTUATOR_STALL (0x05)
GPIOE (BTN_HeadLamp) | Kẹt nút chuyển pha chiếu xa > 1.5s | DTC_B1002 (0x1002) | DTC_SEVERITY_ERROR | ERR_ACTUATOR_STALL (0x05)
GPIOE (BTN_FogLamp) | Kẹt công tắc đèn sương mù > 1.5s | DTC_B1004 (0x1004) | DTC_SEVERITY_ERROR | ERR_ACTUATOR_STALL (0x05)

# CHƯƠNG 6: ĐO KIỂM THỰC NGHIỆM VÀ ĐÁNH GIÁ CHỈ SỐ KỸ THUẬT

## 6.1. Đo kiểm Dạng sóng và Độ trễ Phản hồi (Worst-Case Latency Benchmark)

Sử dụng máy phân tích logic đa kênh Saleae Logic Analyzer đo trực tiếp thời gian trễ từ thời điểm xuất hiện sườn xuống trên chân nút bấm (GPIO Interrupt) đến khi bản tin CAN 0x400 xuất hiện trên đường truyền vi sai CAN_H/CAN_L:

• Thời gian lọc chống rung phím (Debounce Time): 30.0 ms (đạt đúng thiết lập phần mềm).
• Thời gian đóng gói khung truyền UART tại F411: 0.43 ms (5 bytes ở 115200 bps).
• Thời gian bóc tách và định tuyến ngắt tại F103: 0.12 ms (120 µs).
• Thời gian chiếm bus CAN và truyền hoàn tất khung 0x400: 0.26 ms (130 bit ở 500 kbps).
-> TỔNG THỜI GIAN ĐÁP ỨNG BIÊN (EDGE RESPONSE TIME): 30.81 ms. Hoàn toàn thỏa mãn tiêu chuẩn công nghiệp (< 45 ms).

## 6.2. Kiểm thử Tiêm lỗi An toàn chức năng (Fault Injection Testing)

Kết quả thực nghiệm:
Tiến hành 3 bài kiểm tra cưỡng bức trên mô hình phần cứng thực tế:

1. Thử nghiệm Cạn nước rửa kính: Rút chân cảm biến PE9 (mức LOW). Đèn LED đỏ PE10 lập tức sáng. Đúng 300 ms sau, xung PWM chân PC6 bị dập tắt về 0V (đo trên dao động ký). Bản tin DTC B1012 được phát lên CAN Bus. Khi cắm lại cảm biến vào nguồn 3.3V, động cơ bơm vẫn bị khóa cứng, chứng minh thuật toán Latched Fault vận hành chính xác 100%.
2. Thử nghiệm Nhiễu truyền thông UART: Rút ngắt kết nối dây UART TX giữa F411 và F103 trong 100 ms rồi cắm lại. Cơ chế Timeout 25ms tự động xóa bỏ byte rác, không xuất hiện hiện tượng trôi khung truyền, các bản tin sau đó được giải mã chính xác mà không cần khởi động lại mạch.
3. Thử nghiệm Kẹt phím đèn: Đè nút PE13 liên tục. Sau 1.5 giây, LED lỗi PE7 bật sáng, bản tin CAN 0x500 phát mã lỗi 0x1002 (DTC_B1002). Màn hình Qt Dashboard lập tức kéo Banner đỏ cảnh báo 'B1002: High Beam Button Jammed'.

## 6.3. Mức độ Chiếm dụng Bộ nhớ và Hiệu suất CPU (Resource Consumption)

Thông số chiếm dụng tài nguyên phần cứng sau khi biên dịch với cờ tối ưu hóa GCC -O2:

Vi Điều Khiển / Node | Flash ROM Chiếm Dụng | Tỷ Lệ Flash | SRAM Chiếm Dụng | Tải CPU Trung Bình
STM32F103C8T6 (Translator Node) | 14.2 KB / 64 KB | 22.1% | 2.8 KB / 20 KB (14.0%) | < 4.5% (Ngắt toàn phần)
STM32F411VET6 (Actuator Node) | 28.6 KB / 512 KB | 5.5% | 6.4 KB / 128 KB (5.0%) | < 8.2% (DMA hỗ trợ)

# CHƯƠNG 7: KẾT LUẬN VÀ HƯỚNG PHÁT TRIỂN PHÂN HỆ

## 7.1. Kết luận Đóng góp của Kỹ sư Phân hệ Front BCM

Phân hệ phần mềm và firmware Hộp điều khiển thân xe phía trước (Front BCM) do sinh viên Nguyễn Quốc Đạt (MSSV: FMS00045) chủ trì thiết kế và hiện thực hóa đã hoàn thành xuất sắc 100% các mục tiêu kỹ thuật đề ra, đóng góp then chốt vào sự thành công chung của đồ án tốt nghiệp:

1. Hiện thực hóa kiến trúc phần cứng phân tán vi điều khiển kép (Dual-MCU) hoạt động ổn định, cách ly an toàn bus CAN của xe với tải công suất.
2. Xây dựng giải thuật Change-Detection (Shadow Copies) độc đáo trên STM32F103, giải quyết triệt để bài toán nghẽn cổ chai băng thông CAN (500 kbps) sang UART (115200 bps).
3. Thiết lập giao thức UART nối tiếp có khả năng tự phục hồi (Self-Healing) với cơ chế Timeout 25ms chống trôi khung và tự động giải phóng cờ tràn ORE.
4. Hiện thực hóa thành công các giải thuật an toàn chức năng: Khóa lỗi cứng Latched Fault bảo vệ cháy bơm nước (DTC B1012), quy tắc an toàn quang học triệt tiêu điểm mù Pha/Cos, và bộ giám sát Watchdog kẹt phím vật lý chuẩn đoán SAE J2012.

## 7.2. Định hướng Phát triển Nâng cao

1. Chuyển đổi sang kiến trúc AUTOSAR Classic: Tách lớp phần mềm thành các tầng MCAL, BSW, RTE và SWC để nâng cao khả năng tái sử dụng trên các vi điều khiển cấp độ ô tô chuyên dụng (Automotive Grade như NXP S32K hoặc Infineon Aurix).
2. Nâng cấp đường truyền lên CAN-FD (Flexible Data-rate): Nâng băng thông truyền tải lên 2 - 5 Mbps với kích thước khung dữ liệu 64 bytes, phục vụ tích hợp thêm các cảm biến Radar sóng milimet (mmWave) phát hiện va chạm sớm phía trước.
