tumo07/vehicle-dashboard-cluster/project_guide.html

# 🚗 Smart Vehicle Dashboard Cluster

CAN v3.0 Coordinator Architecture — Production Master Guide

TẬP ĐOÀN FPT — VIỆN ĐÀO TẠO QUỐC TẾ FPT TP.HCM (FAI)

GVHD: Phạm Toàn Văn Võ (Senior Embedded Engineer @ HELLA)

Lớp: M1.2510.E0 | Nhóm 2 | 09/2026

Trịnh Đăng Khoa

SE203770 • Lead / Architect

Nguyễn Đăng Cao Huy

FMS00041 • Rear BCM

Nguyễn Quốc Đạt

FMS00045 • Front BCM

Lê Công Tiểu Long

FMS00049 • Gateway & Đo kiểm

Nguyễn P. Duy Thắng

FMS00038 • HMI Qt 6 / QML

🔌 Overview Central ECU (F407) Front BCM (F411+F103) Rear BCM (BluePill) Gateway (BluePill) 📡 CAN v3.0 Protocol 🔨 Build & Flash

## System Architecture — CAN Bus Topology

### ⚡ Bus Rules & Grounding

- • COMMON GROUND: All 4 boards must connect their GND pins together. Missing common ground causes frame corruption and silent RX failures.
- • 120Ω TERMINATORS: Exactly two 120Ω resistors must be placed across CANH and CANL at the two physical ends of the line.
- • BAUD RATE: Standard automotive 500 kbps.

### 🛡️ Fail-Safe Architectures

- • Front BCM: If CAN link is lost for > 1.2s, board enters Fail-Safe Mode (forces Low Beams ON 100%, turns LD5 Red LED ON).
- • Central Coordinator: Central ECU validates all user requests before executing. Rejects trunk commands if vehicle speed > 5 km/h.
- • Smart Kick Trunk: Ultrasonic proximity trigger set to strictly ≤ 8cm to avoid false triggers while driving.

## Central ECU — STM32F407 Discovery

The Central Master Coordinator. Ingests user commands from Qt (0x100–0x104), validates states, routes approved executions (0x200–0x211), and broadcasts state (0x300–0x304) and sync ticks (0x130).

### 📌 Pin Assignment

Pin | Peripheral / Function | Hardware Description
PA1 | ADC1_CH1 | Speed Simulator Potentiometer (0–150 km/h)
PA2 | ADC1_CH2 | Gear / Fuel Simulator Pot (P, R, N, D, S)
PA0 | USER Button | Local Headlight Toggle (Active HIGH)
PB8 | CAN1_RX | Connects to CAN Transceiver CRX / RXD
PB9 | CAN1_TX | Connects to CAN Transceiver CTX / TXD
PD12 | LED Green | Vehicle Speed < 60 km/h
PD13 | LED Orange | Vehicle Speed 60–99 km/h
PD14 | LED Red | Vehicle Speed ≥ 100 km/h
PD15 | LED Blue | CAN TX Activity indicator

### ⚙️ Internal Timers & Logic

• TIM6 (100ms): Master sample loop for ADC potentiometers, vehicle state broadcast (0x300), and Central Heartbeat (0x700).

• TIM7 (500ms): Turn Signal Synchronization Pulse (0x130 Blink Tick).

• Multi-beam Light Bitmask Accumulator: Central ECU dynamically accumulates active lights into EXEC_FRONT_LIGHTS (0x200) so DRL, Low Beam, High Beam, and Fog can stay lit concurrently.

• Watchdog Timeout (2500ms): Raised threshold from 500ms to 2500ms to eliminate false alarms while guaranteeing strict 1000ms node fault detection.

• PA0 USER Button: Cycles lighting states (Off → Low Beam → High Beam → Fog) and immediately transmits 0x200 over CAN.

## Front BCM — Dual Board Architecture (F411 + F103)

To preserve automotive isolation, the Front BCM splits duties: F103 acts as the CAN Bridge, while F411 executes actuator hardware.

### 📌 Logic Board — STM32F411 Discovery

Pin | Peripheral / Function | Hardware Description
PA0 | ADC1_IN0 | Rain Sensor Analog Input (adc_dma_buffer[0])
PC1 | ADC1_IN11 | Headlight Dimmer Potentiometer (adc_dma_buffer[1])
PA2 | USART2_TX | UART TX → F103 PA10 (RX)
PA3 | USART2_RX | UART RX ← F103 PA9 (TX)
PD12 (LD4) | CAN State LED | GREEN ON = CAN Link Active & OK
PD14 (LD5) | Fail-Safe LED | RED ON = Bus Lost > 1.2s (Fail-Safe active)
PB7 | TIM4_CH2 PWM | Low Beam Headlight (Cos)
PB8 | TIM4_CH3 PWM | High Beam Headlight (Pha)
PE11 | GPIO Out | DRL LED Indicator
PE12 | GPIO Out | Fog Lamp LED Indicator
PC4 | GPIO Out | Turn Signal Left LED
PC5 | GPIO Out | Turn Signal Right LED
PA1 | TIM2_CH2 PWM | Wiper Servo Motor
PC6 | TIM3_CH1 PWM | Washer Fluid Pump Motor
PE9 | GPIO In | Washer Fluid Level Float Sensor
PE10 | GPIO Out | Low Fluid Warning LED
PE7 | GPIO Out | DTC Error LED Indicator
PB0 / PB1 | GPIO In | Turn Left / Turn Right Buttons
PB2 | GPIO In | Hazard Light Button
PE8 | GPIO In | Wiper Mode Toggle Button
PE13-15 | GPIO In | Headlamp / Low-High / Fog Buttons

### 📌 Bridge Board — BluePill (STM32F103C8)

Pin | Function | Target
PA11 | CAN_RX | CAN Transceiver CRX / RXD
PA12 | CAN_TX | CAN Transceiver CTX / TXD
PC13 | CAN Activity LED | Onboard User LED (Toggles on every CAN RX/TX)
PA9 | USART1_TX | Connects to F411 PA3 (RX)
PA10 | USART1_RX | Connects to F411 PA2 (TX)
PA2/PA3 | USART2 | Debug logging to PC (115200 baud)

⚠️ Critical Wiring Rule:

The F411 never touches the CAN wires. It communicates strictly through UART to the F103. If you connect PA2 to PA9 directly, you wired TX-to-TX and the heartbeat will die! Always wire PA2 → PA10 and PA3 → PA9.

🟢 Visual LED Indicators

- • PC13 (BluePill): Blinks on every CAN RX/TX packet (1Hz heartbeat + 200ms reports).
- • LD4 / PD12 (F411): Solid GREEN when CAN link with Central is alive & healthy.
- • LD5 / PD14 (F411): RED if CAN link lost > 1.2s (ASIL-B fail-safe triggers 100% low beam).
- • PE7 (F411): DTC error indicator LED.

💡 Headlight & Fog Controls

- • PE14: Master Headlight ON/OFF toggle switch.
- • PE13: Toggle Low Beam (PB7 PWM) ↔ High Beam (PB8 PWM).
- • PE15: Toggle Fog Lamp (PE12).
- • PC1: Analog Dimmer Potentiometer (ADC1_IN11) controls brightness duty cycle.

⚡ Turn & Wiper Controls

- • PB0 / PB1: Left / Right Turn Signal Buttons.
- • PB2: Hazard Warning Toggle (flashes PC4 & PC5 synchronously via CAN 0x130).
- • PE8: Wiper Mode Button (OFF → INT → LOW → HIGH).

## Rear BCM — BluePill (STM32F103C8)

Controls the Smart Kick Trunk (SG90 Servo), HC-SR04 Reverse Ultrasonic Radar, Tail & Brake LEDs, and Reverse lights.

### 📌 Pin Assignment

Pin | Function | Notes
PA11 | CAN_RX | CAN Transceiver CRX
PA12 | CAN_TX | CAN Transceiver CTX
PB6 | TIM4_CH1 PWM | Trunk SG90 Servo (0°=Closed, 90°=Open)
PB12 | GPIO Out | HC-SR04 TRIG (10µs trigger pulse)
PB13 | GPIO In | HC-SR04 ECHO (Use 5V → 3.3V divider!)
PA0 | Button In | Brake Pedal simulation (Active HIGH)
PA1 | Button In | Trunk Manual Switch (Active HIGH)
PA4 | Switch In | Reverse Gear Switch (R simulation)
PA5 | Button In | Rear Left Turn Signal Button (Toggle, Active HIGH)
PA6 | Button In | Rear Right Turn Signal Button (Toggle, Active HIGH)
PB0 | LED Out | Brake Light (Solid ON during braking)
PA2 | LED Out | Reverse Buzzer / LED Warning
PB1/PB3 | LED Out | Rear Turn Signals (PB1 Left, PB3 Right)

### 🚨 Turn Signal & Brake Coordination

• Front & Rear Phase Sync: Turn signals decode level phase from Central ECU's 0x130 BLINK_TICK. Both Front and Rear blink synchronously at 1Hz (500ms ON / 500ms OFF) with zero toggle drift.

• Push-to-Toggle Debouncing (PA5/PA6): 50ms edge debouncing with instant 0x410 dispatch ensures immediate response without holding the button.

• FMVSS 108 Brake Coordination: When brake pedal (PA0) is pressed, dedicated brake (PB0) turns solid ON, while active turn signals continue flashing without interruption.

• Fail-Safe Blinking: Automatic 500ms local blink fallback if CAN ticks stop for > 1500ms.

### 🧳 Parking Radar & Kick Trunk

• Desktop Demo Radar Limits: Critical ≤ 10cm, Warning ≤ 20cm, Caution ≤ 30cm, Clear > 30cm.

• Kick Trunk Calibration: Calibrated to 2–8 cm for hands-free kick opening without false triggers.

• Safety Interlock: Central ECU unconditionally denies trunk opening if Vehicle Speed > 5 km/h or Gear is in Drive/Reverse.

## Translator Gateway — BluePill (STM32F103C8)

Translates between the 500kbps CAN Bus and 115200 baud ASCII UART connected to the Qt 6 Dashboard running on the laptop.

### 📌 Pin Assignment

Pin | Peripheral | Connection
PA11 | CAN_RX | CAN Transceiver CRX
PA12 | CAN_TX | CAN Transceiver CTX
PA9 | USART1_TX | USB-UART Adapter RXD (to PC)
PA10 | USART1_RX | USB-UART Adapter TXD (to PC)

### 💻 PC Serial Protocol

• Format: CAN:<ID_HEX>:<DLC>:<DATA_HEX>\r\n

• Example: CAN:100:2:0264\r\n (Commands Low Beam at 100% brightness)

• Handled automatically by Qt's CanBusGateway.cpp and our can_monitor.py tool.

## 📡 CAN v3.0 Protocol Matrix

Standard 11-bit CAN identifiers organized into 7 functional groups.

Group | CAN ID | Source → Dest | Timing | Payload Definition
Group A (Commands) | 0x100 | Qt → Central | Event | [Byte0: CmdLight_t, Byte1: Brightness %]
| 0x101 | Qt → Central | Event | [Byte0: CmdWiper_t, Byte1: Washer 0/1]
| 0x102 | Qt → Central | Event | [Byte0: CmdTurn_t (0=Off, 1=L, 2=R, 3=Hazard)]
| 0x103 | Qt → Central | Event | [Byte0: CmdTrunk_t (0=None, 1=Open, 2=Close)]
| 0x105 | Central → Qt | ≤10ms | ACK/NACK: [TargetCmd, AckStatus, Reason]
Sync | 0x130 | Central → ALL | 500ms | Blink Tick: Turn Signal Master Phase Pulse
Group B (Executions) | 0x200 | Central → Front | Event | [Byte0: ExecFrontLight_t bitmask, Byte1: Bri %]
| 0x201 | Central → Front | Event | [Byte0: WiperMode, Byte1: Spray 0/1]
| 0x202 | Central → Front | Event | [Byte0: ExecTurn_t bitmask (L/R/Hazard)]
| 0x211 | Central → Rear | Event | [Byte0: CmdTrunk_t (Execute open/close)]
Group C (Telemetry) | 0x300 | Central → Qt | 100ms | Vehicle State: Gear, Flags, Speed, Fuel, Temp, Volt
| 0x301 | Central → Qt | 500ms | Active Lights: DRL, Low, High, Fog, WiperMode
| 0x302 | Central → Qt | 500ms | Turn Blink Phase: Bit0=Left ON, Bit1=Right ON
| 0x303 | Central → Qt | 200ms | Trunk State: Open % (0-100), MotorState (0-3)
| 0x304 | Central → Qt | 100ms | Reverse Radar: Distance cm (0xFFFF=None), Level
Group D (Reports) | 0x400 | Front → Central | 200ms | Front Actuators status, Wiper mode, Motor health %
| 0x401 | Front → Central | 500ms | Rain Sensor % (0-100), Washer Fluid Level %
| 0x410 | Rear → Central | 200ms | Rear Actuators status, Trunk Motor, Open %
| 0x411 | Rear → Central | 100ms | Ultrasonic Radar dist cm, Trunk Hall Switch
Group E/F (Safety) | 0x500 / 0x510 | BCMs → Central | On-Fault | DTC Report: Severity, DTC Code, Count, ErrType
| 0x600 | Central → Qt | Event | Banner Fault: Node ID, Severity, DTC Code
| 0x610 | Central → Qt | 1000ms | Watchdog Alert: Silent Node ID, Duration (s)
Group G (Heartbeat) | 0x700 | Central ECU | 100ms | Uptime counter + Health Flags (Init, CAN, DTC)
| 0x710 | Front BCM | 1000ms | Uptime counter + Health Flags
| 0x720 | Rear BCM | 1000ms | Uptime counter + Health Flags

## 🔨 Build & Flash Guide for Academic Verification

### 1. One-Click IDE Import

All projects use 100% relative include paths. The examining supervisor can clone anywhere (C:, D:, Mac, Linux) and import cleanly without missing-path errors:

1. Open STM32CubeIDE → File → Import
2. Select General → Existing Projects into Workspace
3. Browse to repository root → Click Finish
4. Click Project → Build All (Ctrl+B)

### 2. Live Bus Monitor & Interactive Injector

We provide a dedicated Python script that decodes 100% of CAN v3.0 messages without spamming duplicate heartbeats, plus live keyboard command injection:

python front_bcm_firmware/can_monitor.py COM9

⌨️ Live Injector Keystrokes:

Key | Action | CAN Frame Injected
1 | Low Beam ON (100%) | 0x100 [0x02, 100]
2 | High Beam ON (100%) | 0x100 [0x04, 100]
0 | ALL Lights OFF | 0x100 [0x00, 0]
h | Toggle Hazard Blinkers | 0x102 [0x03]
w | Cycle Wiper Speed (Off→Int→Low→High) | 0x101 [mode, 0]
t | Toggle Trunk (Open / Close) | 0x103 [action]
clear | Clear All Diagnostic DTC Faults | 0x601 [0x00, 0x00]
