tumo07/vehicle-dashboard-cluster/rear_bcm_firmware/Core/Src/main.c

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

/* Includes ------------------------------------------------------------------*/
#include "main.h"
#include "can_messages.h"

CAN_HandleTypeDef hcan;
TIM_HandleTypeDef htim3; // Dùng để delay micro-giây cho HC-SR04
TIM_HandleTypeDef htim4; // Dùng cho Servo Cốp xe (PB6)

/* USER CODE BEGIN PV */
CAN_TxHeaderTypeDef TxHeader;
uint32_t TxMailbox;
uint8_t TxData[8];
// ----- BIẾN LƯU LỆNH TỪ CENTRAL ECU -----
volatile uint8_t exec_rear_turn_mask = 0;

// ----- BIẾN ĐIỀU KHIỂN XI-NHAN ĐỒNG BỘ (CAN v3.0 / FMVSS 108) -----
static uint32_t         lastFlashTime          = 0;
static uint8_t          local_failsafe_flash   = 0;
static uint32_t         last_can_tick_time     = 0;
static volatile uint8_t rear_cmd_blink_tick    = 0;
static volatile uint8_t rear_can_connected     = 0;

// Nút bấm xi-nhan cục bộ trên Rear BCM (PA5 / PA6) - Chống rung 50ms & gửi request lên Central ECU
static uint8_t          last_left_turn_btn     = GPIO_PIN_RESET;
static uint8_t          last_right_turn_btn    = GPIO_PIN_RESET;
static uint32_t         last_turn_debounce     = 0;

// ----- BIẾN CHO CỐP XE -----
uint32_t last_kick_time = 0;
uint8_t trunk_state = 0;     // 0 = Cốp đóng, 1 = Cốp mở
uint8_t foot_in_zone = 0;    // Cờ chống nhận diện liên tục khi để tay lâu

// Biến cho thuật toán chạy Servo mượt (Sweep)
uint16_t current_servo_pwm = 500; // Bắt đầu ở 0.5ms (0 độ)
uint16_t target_servo_pwm = 500;
uint32_t last_servo_move = 0;
// Biến trạng thái vật lý
volatile uint8_t brake_pedal = 0;
volatile uint8_t trunk_switch = 0;
uint8_t last_trunk_switch = 0;
volatile uint8_t is_reversing = 0;
volatile uint8_t central_is_reversing = 0;
volatile uint8_t left_turn = 0;
volatile uint8_t right_turn = 0;

// Biến cho logic Non-blocking
uint32_t last_can_tx = 0;
uint32_t last_beep_time = 0;
uint16_t distance_cm = 0;
/* USER CODE END PV */

void SystemClock_Config(void);
static void MX_GPIO_Init(void);
static void MX_CAN_Init(void);
static void MX_TIM4_Init(void);
static void MX_TIM3_Init(void);

/* USER CODE BEGIN 0 */
// Hàm delay theo micro-giây bằng TIM3
void Delay_us(uint16_t us) {
    __HAL_TIM_SET_COUNTER(&htim3, 0);
    while (__HAL_TIM_GET_COUNTER(&htim3) < us);
}

// Hàm đọc cảm biến siêu âm HC-SR04 an toàn (có chống treo chip)
uint16_t HCSR04_Read(void) {
    uint32_t local_time = 0;

    // Kích xung Trigger 10us
    HAL_GPIO_WritePin(GPIOB, GPIO_PIN_12, GPIO_PIN_SET);
    Delay_us(10);
    HAL_GPIO_WritePin(GPIOB, GPIO_PIN_12, GPIO_PIN_RESET);

    // Chờ chân Echo lên mức Cao (Có Timeout để chống treo mạch)
    uint32_t timeout = HAL_GetTick();
    while (!(HAL_GPIO_ReadPin(GPIOB, GPIO_PIN_13))) {
        if (HAL_GetTick() - timeout > 10) return 0; // Quá 10ms không thấy sóng dội
    }

    // Bắt đầu đo độ rộng xung Echo
    __HAL_TIM_SET_COUNTER(&htim3, 0);
    while (HAL_GPIO_ReadPin(GPIOB, GPIO_PIN_13)) {
        local_time = __HAL_TIM_GET_COUNTER(&htim3);
        if (local_time > 25000) return 400; // Tối đa ~4 mét, thoát sớm
    }

    // Công thức: Khoảng cách (cm) = Thời gian (us) / 58
    return local_time / 58;
}

// Hàm gửi yêu cầu điều khiển CỐP lên Central ECU (CAN ID 0x103)
void Rear_RequestTrunkAction(CmdTrunk_t req_cmd) {
    CAN_TxHeaderTypeDef reqHeader;
    uint32_t reqMailbox;
    uint8_t reqData[1];

    reqHeader.StdId = CAN_ID_CMD_TRUNK_CONTROL; // 0x103
    reqHeader.ExtId = 0x00;
    reqHeader.RTR   = CAN_RTR_DATA;
    reqHeader.IDE   = CAN_ID_STD;
    reqHeader.DLC   = 1;
    reqHeader.TransmitGlobalTime = DISABLE;

    reqData[0] = (uint8_t)req_cmd;

    HAL_CAN_AddTxMessage(&hcan, &reqHeader, reqData, &reqMailbox);
}

// Hàm gửi yêu cầu XI-NHAN lên Central ECU (CAN ID 0x102)
void Rear_SendTurnRequest(CmdTurn_t req_cmd) {
    CAN_TxHeaderTypeDef reqHeader;
    uint32_t reqMailbox;
    uint8_t reqData[1];

    reqHeader.StdId = CAN_ID_CMD_TURN_SIGNAL; // 0x102
    reqHeader.ExtId = 0x00;
    reqHeader.RTR   = CAN_RTR_DATA;
    reqHeader.IDE   = CAN_ID_STD;
    reqHeader.DLC   = 1;
    reqHeader.TransmitGlobalTime = DISABLE;

    reqData[0] = (uint8_t)req_cmd;

    HAL_CAN_AddTxMessage(&hcan, &reqHeader, reqData, &reqMailbox);
}

// Hàm gửi báo cáo trạng thái BCM Sau lên Central ECU (CAN ID 0x410)
void Rear_SendStatusReport(void) {
    CAN_TxHeaderTypeDef hdr;
    uint32_t mbox;
    uint8_t d[3];

    hdr.StdId = CAN_ID_REPORT_REAR_STATUS; // 0x410
    hdr.ExtId = 0x01;
    hdr.RTR   = CAN_RTR_DATA;
    hdr.IDE   = CAN_ID_STD;
    hdr.DLC   = 3;
    hdr.TransmitGlobalTime = DISABLE;

    d[0] = 0x00;
    if (brake_pedal == GPIO_PIN_SET) d[0] |= REAR_ACT_BRAKE;
    if ((exec_rear_turn_mask & EXEC_TURN_LEFT_ARM) || (exec_rear_turn_mask & EXEC_TURN_HAZARD_ARM))
        d[0] |= REAR_ACT_LTURN;
    if ((exec_rear_turn_mask & EXEC_TURN_RIGHT_ARM) || (exec_rear_turn_mask & EXEC_TURN_HAZARD_ARM))
        d[0] |= REAR_ACT_RTURN;
    if (current_servo_pwm != target_servo_pwm) d[0] |= REAR_ACT_TRUNK_ACTIVE;

    if (current_servo_pwm < target_servo_pwm)      d[1] = TRUNK_OPENING;
    else if (current_servo_pwm > target_servo_pwm) d[1] = TRUNK_CLOSING;
    else                                           d[1] = TRUNK_IDLE;

    uint8_t open_pct = 0;
    if (current_servo_pwm >= 500) {
        open_pct = (uint8_t)(((uint32_t)(current_servo_pwm - 500) * 100U) / 2000U);
        if (open_pct > 100) open_pct = 100;
    }
    d[2] = open_pct;

    HAL_CAN_AddTxMessage(&hcan, &hdr, d, &mbox);
}

// Task xuất điều khiển đèn phanh & xi-nhan - FLASH ONLY (lệnh do Central ECU quản lý hoàn toàn qua 0x210 & 0x130)
void Rear_TurnSignal_Task(uint32_t currentTime) {
    uint8_t left_active  = (exec_rear_turn_mask & EXEC_TURN_LEFT_ARM)  || (exec_rear_turn_mask & EXEC_TURN_HAZARD_ARM);
    uint8_t right_active = (exec_rear_turn_mask & EXEC_TURN_RIGHT_ARM) || (exec_rear_turn_mask & EXEC_TURN_HAZARD_ARM);

    // Đồng bộ nhịp chớp từ Central ECU (0x130) với Fail-safe fallback
    uint8_t flashState = 0;
    if (left_active || right_active) {
        if (rear_can_connected && (currentTime - last_can_tick_time < 1500)) {
            // Đồng bộ 100% với nhịp phát 0x130 của Central ECU
            flashState = (rear_cmd_blink_tick & 0x01);
        } else {
            // Fail-safe 500ms khi mất kết nối CAN
            if (currentTime - lastFlashTime >= 500) {
                local_failsafe_flash = !local_failsafe_flash;
                lastFlashTime = currentTime;
            }
            flashState = local_failsafe_flash;
        }
    } else {
        flashState = 0;
        lastFlashTime = currentTime;
    }

    // Xuất LED: Xi-nhan nhấp nháy theo flashState. Nếu không nháy thì đèn phanh điều khiển.
    GPIO_PinState leftLED  = left_active  ? (flashState ? GPIO_PIN_SET : GPIO_PIN_RESET) : ((brake_pedal == GPIO_PIN_SET) ? GPIO_PIN_SET : GPIO_PIN_RESET);
    GPIO_PinState rightLED = right_active ? (flashState ? GPIO_PIN_SET : GPIO_PIN_RESET) : ((brake_pedal == GPIO_PIN_SET) ? GPIO_PIN_SET : GPIO_PIN_RESET);

    // Đèn phanh chuyên dụng PB0
    HAL_GPIO_WritePin(GPIOB, GPIO_PIN_0, (brake_pedal == GPIO_PIN_SET) ? GPIO_PIN_SET : GPIO_PIN_RESET);

    // Đèn xi-nhan / phanh sau PB1 (Trái) & PB3 (Phải)
    HAL_GPIO_WritePin(GPIOB, GPIO_PIN_1, leftLED);
    HAL_GPIO_WritePin(GPIOB, GPIO_PIN_3, rightLED);
}
/* USER CODE END 0 */

int main(void)
{
  HAL_Init();
  SystemClock_Config();

  MX_GPIO_Init();
  MX_CAN_Init();
  MX_TIM4_Init();
  MX_TIM3_Init();

  /* USER CODE BEGIN 2 */
  // Khởi động Timer
  HAL_TIM_PWM_Start(&htim4, TIM_CHANNEL_1);
  __HAL_TIM_SET_COMPARE(&htim4, TIM_CHANNEL_1, 500); // 1.0ms - Mặc định Cốp đóng
  HAL_TIM_Base_Start(&htim3); // Bật TIM3 chạy ngầm cho HC-SR04

  // Cấu hình Bộ lọc CAN
  CAN_FilterTypeDef canfilterconfig;
  canfilterconfig.FilterActivation = CAN_FILTER_ENABLE;
  canfilterconfig.FilterBank = 0;
  canfilterconfig.FilterFIFOAssignment = CAN_FILTER_FIFO0;
  canfilterconfig.FilterIdHigh = 0x0000;
  canfilterconfig.FilterIdLow = 0x0000;
  canfilterconfig.FilterMaskIdHigh = 0x0000;
  canfilterconfig.FilterMaskIdLow = 0x0000;
  canfilterconfig.FilterMode = CAN_FILTERMODE_IDMASK;
  canfilterconfig.FilterScale = CAN_FILTERSCALE_32BIT;
  HAL_CAN_ConfigFilter(&hcan, &canfilterconfig);
  HAL_CAN_Start(&hcan);
  // DÒNG NÀY ĐỂ CHO PHÉP CHIP NGHE MẠNG CAN:
  HAL_CAN_ActivateNotification(&hcan, CAN_IT_RX_FIFO0_MSG_PENDING);

  // Khởi tạo trạng thái chớp xi-nhan
  lastFlashTime      = HAL_GetTick();
  last_turn_debounce = HAL_GetTick();
  /* USER CODE END 2 */

  while (1)
  {
      uint32_t current_time = HAL_GetTick();

      /* 1. ĐỌC TÍN HIỆU NGÕ VÀO VẬT LÝ */
      brake_pedal  = HAL_GPIO_ReadPin(GPIOA, GPIO_PIN_0); // Bàn đạp phanh
      trunk_switch = HAL_GPIO_ReadPin(GPIOA, GPIO_PIN_1); // Công tắc cốp
      is_reversing = HAL_GPIO_ReadPin(GPIOA, GPIO_PIN_4); // Nút giả lập Số Lùi

      /* 2. XỬ LÝ NÚT BẤM XI-NHAN CỤC BỘ (PA5 / PA6) - GỬI REQUEST LÊN CENTRAL ECU */
      if (current_time - last_turn_debounce >= 50) {
          uint8_t curr_left  = HAL_GPIO_ReadPin(GPIOA, GPIO_PIN_5);
          uint8_t curr_right = HAL_GPIO_ReadPin(GPIOA, GPIO_PIN_6);

          // Phát hiện sườn lên nút Trái (PA5) -> Gửi yêu cầu lên Central ECU
          if (curr_left == GPIO_PIN_SET && last_left_turn_btn == GPIO_PIN_RESET) {
              Rear_SendTurnRequest(CMD_TURN_LEFT);
          }

          // Phát hiện sườn lên nút Phải (PA6) -> Gửi yêu cầu lên Central ECU
          if (curr_right == GPIO_PIN_SET && last_right_turn_btn == GPIO_PIN_RESET) {
              Rear_SendTurnRequest(CMD_TURN_RIGHT);
          }

          last_left_turn_btn  = curr_left;
          last_right_turn_btn = curr_right;
          last_turn_debounce  = current_time;
      }

      /* 3. TASK ĐIỀU KHIỂN ĐÈN PHANH & XI-NHAN - FLASH ONLY */
      Rear_TurnSignal_Task(current_time);

      /* 4. LOGIC CẢM BIẾN LÙI VÀ ĐÁ CỐP THÔNG MINH */
      distance_cm = HCSR04_Read();

      uint8_t effective_reversing = is_reversing || central_is_reversing;

      if (effective_reversing == 1) {
          // --- NGỮ CẢNH 1: ĐANG LÙI XE (PARKING SENSOR) ---
          if (distance_cm > 0 && distance_cm <= DIST_THRESHOLD_CRITICAL_CM) {
              HAL_GPIO_WritePin(GPIOA, GPIO_PIN_2, GPIO_PIN_RESET);
          }
          else if (distance_cm > DIST_THRESHOLD_CRITICAL_CM && distance_cm <= DIST_THRESHOLD_CAUTION_CM) {
              uint32_t beep_interval = distance_cm * 8;
              if (current_time - last_beep_time >= beep_interval) {
                  HAL_GPIO_TogglePin(GPIOA, GPIO_PIN_2);
                  last_beep_time = current_time;
              }
          }
          else {
              HAL_GPIO_WritePin(GPIOA, GPIO_PIN_2, GPIO_PIN_SET);
          }
      }
      else {
          // --- NGỮ CẢNH 2: SMART KICK TRUNK (CHỈ GỬI REQUEST, KHÔNG TỰ QUAY SERVO) ---
          HAL_GPIO_WritePin(GPIOA, GPIO_PIN_2, GPIO_PIN_SET);

          if (distance_cm > 2 && distance_cm <= 8) {
              // CHỐNG NHIỄU: Chỉ nhận diện khi rút chân/tay ra rồi mới đưa vào lại (foot_in_zone == 0)
              if (foot_in_zone == 0 && (current_time - last_kick_time > 2000)) {
                  // Gửi yêu cầu đóng/mở cốp lên Central ECU (0x103) để Central ECU xét duyệt an toàn
                  Rear_RequestTrunkAction(trunk_state == 1 ? CMD_TRUNK_CLOSE : CMD_TRUNK_OPEN);
                  foot_in_zone = 1;
                  last_kick_time = current_time;
              }
          } else {
              foot_in_zone = 0;
          }
      }

      // --- NÚT BẤM CỐP VẬT LÝ TRÊN XE (PA1) ---
      if (trunk_switch == GPIO_PIN_SET && last_trunk_switch == GPIO_PIN_RESET) {
          // Khi bấm nút mở cốp vật lý -> Gửi yêu cầu lên Central ECU phê duyệt (0x103)
          Rear_RequestTrunkAction(trunk_state == 1 ? CMD_TRUNK_CLOSE : CMD_TRUNK_OPEN);
      }
      last_trunk_switch = trunk_switch;

      // --- THUẬT TOÁN QUÉT MƯỢT SERVO (NON-BLOCKING SWEEP) ---
      // Nếu vị trí hiện tại chưa tới mục tiêu do Central ECU chỉ định, nhích nhanh mượt mà
      if (current_servo_pwm != target_servo_pwm) {
          if (current_time - last_servo_move >= 5) { // Cứ 5ms nhích 1 lần

              if (current_servo_pwm < target_servo_pwm) {
                  current_servo_pwm += 30; // Tăng nhanh PWM để mở cốp nhanh
                  if (current_servo_pwm > target_servo_pwm) current_servo_pwm = target_servo_pwm;
              } else {
                  current_servo_pwm -= 30; // Giảm nhanh PWM để đóng cốp nhanh
                  if (current_servo_pwm < target_servo_pwm) current_servo_pwm = target_servo_pwm;
              }

              // Bơm độ rộng xung ra chân PB6
              __HAL_TIM_SET_COMPARE(&htim4, TIM_CHANNEL_1, current_servo_pwm);
              last_servo_move = current_time;
          }
      }

      /* 5. TRUYỀN GÓI TIN CAN CHUẨN ĐỒ ÁN V3.0 (CHU KỲ 200ms) */
      if (current_time - last_can_tx >= 200) {
          last_can_tx = current_time;

          // GÓI 1: 0x410 - TRẠNG THÁI NÚT BẤM & ĐỘNG CƠ CỐP
          Rear_SendStatusReport();

          // GÓI 2: 0x411 - KHOẢNG CÁCH SIÊU ÂM (Gửi 4 Byte)
          TxHeader.StdId = CAN_ID_REPORT_REAR_SENSORS; // 0x411
          TxHeader.DLC = 4; // DLC 4 Byte

          // Byte 0 & 1: Khoảng cách cm (Dùng Macro PACK_U16)
          TxData[0] = UNPACK_HIGH_BYTE(distance_cm);
          TxData[1] = UNPACK_LOW_BYTE(distance_cm);

          // Byte 2: Trạng thái chốt vật lý (Hall effect: 1=Mở, 0=Đóng)
          TxData[2] = (current_servo_pwm > 500) ? 1 : 0;

          // Byte 3: Tính toán mức độ đỗ xe an toàn (Xanh/Vàng/Đỏ)
          TxData[3] = effective_reversing ? CALC_PARKING_LEVEL(distance_cm) : PARKING_CLEAR;

          HAL_CAN_AddTxMessage(&hcan, &TxHeader, TxData, &TxMailbox);

          // GÓI 3: 0x720 - REAR BCM HEARTBEAT
          TxHeader.StdId = CAN_ID_HEARTBEAT_REAR_BCM;
          TxHeader.DLC = 2;
          static uint8_t hb_counter = 0;
          TxData[0] = hb_counter++; // Tăng dần mỗi chu kỳ để báo trạng thái hoạt động liên tục
          TxData[1] = HB_INIT_OK | HB_CAN_OK | HB_SENSORS_OK;
          HAL_CAN_AddTxMessage(&hcan, &TxHeader, TxData, &TxMailbox);
      }
  }
}

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
/* USER CODE BEGIN 4 */
void HAL_CAN_RxFifo0MsgPendingCallback(CAN_HandleTypeDef *hcan)
{
    CAN_RxHeaderTypeDef RxHeader;
    uint8_t RxData[8];

    // Đọc gói tin từ trong hòm thư (FIFO0) ra
    if (HAL_CAN_GetRxMessage(hcan, CAN_RX_FIFO0, &RxHeader, RxData) == HAL_OK)
    {
        // 1. Nhận nhịp chớp đồng bộ từ Central ECU (0x130)
        if (RxHeader.StdId == CAN_ID_BLINK_TICK && RxHeader.DLC >= 1)
        {
            static uint8_t last_raw_tick = 0xFF;
            static uint8_t internal_phase = 0;
            if (RxData[0] != last_raw_tick) {
                last_raw_tick = RxData[0];
                internal_phase = (RxData[0] & 0x01);
            } else {
                internal_phase ^= 1;
            }
            rear_cmd_blink_tick = internal_phase;
            last_can_tick_time = HAL_GetTick();
            rear_can_connected = 1;
        }

        // 2. Nhận lệnh điều khiển CỐP từ Central ECU (0x211)
        else if (RxHeader.StdId == CAN_ID_EXEC_REAR_TRUNK)
        {
            if (RxData[0] == CMD_TRUNK_OPEN)
            {
                trunk_state = 1;
                target_servo_pwm = 2500; // Mở 180 độ
            }
            else if (RxData[0] == CMD_TRUNK_CLOSE)
            {
                trunk_state = 0;
                target_servo_pwm = 500;  // Đóng 0 độ
            }
            else if (RxData[0] == CMD_TRUNK_STOP)
            {
                target_servo_pwm = current_servo_pwm; // Dừng ngay vị trí hiện tại
            }
        }

        // 3. Nhận lệnh điều khiển XI-NHAN/HAZARD từ Central ECU (0x210)
        else if (RxHeader.StdId == CAN_ID_EXEC_REAR_TURN && RxHeader.DLC >= 1)
        {
            exec_rear_turn_mask = RxData[0]; // Cập nhật bitmask để Rear_TurnSignal_Task xử lý
            rear_can_connected = 1;
        }

        // 4. Nhận trạng thái số và cờ vận hành từ Central ECU (0x300)
        else if (RxHeader.StdId == CAN_ID_STATUS_VEHICLE_STATE && RxHeader.DLC >= 2)
        {
            uint8_t current_gear = RxData[0];
            uint8_t state_flags  = RxData[1];
            central_is_reversing = (current_gear == GEAR_REVERSE) || (state_flags & STATE_REVERSE_ACTIVE);
        }

    }
}
/* USER CODE END 4 */
void Error_Handler(void)
{
  __disable_irq();
  while (1)
  {
  }
}

#ifdef USE_FULL_ASSERT
void assert_failed(uint8_t *file, uint32_t line)
{
}
#endif /* USE_FULL_ASSERT */
