tumo07/vehicle-dashboard-cluster/main_mcu_firmware/Central_ECU_BluePill/Core/Inc/main.h

#define CAN_RX_PIN          GPIO_PIN_8
#define CAN_RX_PORT         GPIOB
#define CAN_TX_PIN          GPIO_PIN_9
#define CAN_TX_PORT         GPIOB
#define UART1_TX_PIN        GPIO_PIN_9
#define UART1_TX_PORT       GPIOA
#define UART1_RX_PIN        GPIO_PIN_10
#define UART1_RX_PORT       GPIOA
#define ADC_SPEED_PIN       GPIO_PIN_0     /* PA0 - ADC1 CH0 - speed potentiometer */
#define ADC_SPEED_PORT      GPIOA
#define ADC_FUEL_PIN        GPIO_PIN_1     /* PA1 - ADC1 CH1 - fuel potentiometer  */
#define ADC_FUEL_PORT       GPIOA
#define BTN_HEADLIGHT_PIN   GPIO_PIN_2     /* PA2 - active HIGH, pull-down */
#define BTN_HEADLIGHT_PORT  GPIOA
#define LED_CAN_TX_PIN      GPIO_PIN_13   /* PC13 */
#define LED_CAN_TX_PORT     GPIOC
#define LED_GREEN_PIN       GPIO_PIN_0    /* PB0  - speed < 60 km/h  */
#define LED_GREEN_PORT      GPIOB
#define LED_ORANGE_PIN      GPIO_PIN_1    /* PB1  - 60..99 km/h      */
#define LED_ORANGE_PORT     GPIOB
#define LED_RED_PIN         GPIO_PIN_12   /* PB12 - speed >= 100 km/h */
#define LED_RED_PORT        GPIOB
