tumo07/vehicle-dashboard-cluster/front_bcm_firmware/Logic_F411/Core/Src/main.c

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
/* Includes ------------------------------------------------------------------*/
#include "main.h"

/* USER CODE BEGIN Includes */
#include "main.h"
#include "turnsignal.h"
#include "wiper.h"
#include "headlight.h"
#include "can_messages.h"
#include "TX_data_UART.h"
#include "RX_data_UART.h"
/* USER CODE END Includes */

ADC_HandleTypeDef hadc1;
DMA_HandleTypeDef hdma_adc1;

TIM_HandleTypeDef htim2;
TIM_HandleTypeDef htim3;
TIM_HandleTypeDef htim4;

UART_HandleTypeDef huart2;

/* USER CODE BEGIN PV */
volatile uint32_t leftHoldTime = 0, rightHoldTime = 0, wiperHoldTime = 0, hazardHoldTime = 0;
volatile uint8_t leftHolding = 0, rightHolding = 0, wiperHolding = 0, hazardHolding = 0;
volatile uint8_t leftSent = 0, rightSent = 0, wiperSent = 0, hazardSent = 0;

volatile uint32_t headHoldTime = 0, cosHoldTime = 0, fogHoldTime = 0;
volatile uint8_t headHolding = 0, cosHolding = 0, fogHolding = 0;
volatile uint8_t headSent = 0, cosSent = 0, fogSent = 0;

volatile uint8_t err_counter = 0;
uint16_t adc_dma_buffer[2]; // [0]: Cảm biến mưa (PA0), [1]: Dimmer đèn (PC1)

/* USER CODE END PV */

void SystemClock_Config(void);
static void MX_GPIO_Init(void);
static void MX_DMA_Init(void);
static void MX_TIM2_Init(void);
static void MX_ADC1_Init(void);
static void MX_USART2_UART_Init(void);
static void MX_TIM3_Init(void);
static void MX_TIM4_Init(void);
/* USER CODE BEGIN PFP */
extern void Bridge_SendError(uint8_t errorCode, uint8_t errorMask);



/* USER CODE END PFP */

/**
  * @brief  The application entry point.
  * @retval int
  */
int main(void)
{

  /* MCU Configuration--------------------------------------------------------*/

  /* Reset of all peripherals, Initializes the Flash interface and the Systick. */
  HAL_Init();

  /* Configure the system clock */
  SystemClock_Config();

  /* Initialize all configured peripherals */
  MX_GPIO_Init();
  MX_DMA_Init();
  MX_TIM2_Init();
  MX_ADC1_Init();
  MX_USART2_UART_Init();
  MX_TIM3_Init();
  MX_TIM4_Init();
  /* USER CODE BEGIN 2 */
    HAL_ADC_Start_DMA(&hadc1, (uint32_t*)adc_dma_buffer, 2);
  TurnSignal_Init();
  Bridge_Init(&huart2);
  Wiper_System_Init();
  Headlight_Init(&htim4, &hadc1);
  /* USER CODE END 2 */

  /* Infinite loop */
  /* USER CODE BEGIN WHILE */
  while (1)
    {
    /* USER CODE END WHILE */

    /* USER CODE BEGIN 3 */
	  // 1. Quét lỗi phím bấm giả lập DTC (> 1.5s)
	          if (HAL_GPIO_ReadPin(GPIOB, BTN_TurnLeft_Pin) == GPIO_PIN_RESET) {
	              if (!leftHolding) {
	                  leftHoldTime = HAL_GetTick();
	                  leftHolding = 1;
	                  leftSent = 0;
	              } else if (!leftSent && (HAL_GetTick() - leftHoldTime) >= 1500) {
	                  err_counter++;
	                  Bridge_SendFault(DTC_SEVERITY_ERROR, DTC_B1030, err_counter, ERR_ACTUATOR_STALL);
	                  HAL_GPIO_WritePin(LED_Error_GPIO_Port, LED_Error_Pin, GPIO_PIN_SET); // Bật LED báo lỗi
	                  leftSent = 1;
	              }
	          } else {
	              leftHolding = 0;
	              leftSent = 0;
	          }

	          if (HAL_GPIO_ReadPin(GPIOB, BTN_TurnRight_Pin) == GPIO_PIN_RESET) {
	              if (!rightHolding) {
	                  rightHoldTime = HAL_GetTick();
	                  rightHolding = 1;
	                  rightSent = 0;
	              } else if (!rightSent && (HAL_GetTick() - rightHoldTime) >= 1500) {
	                  err_counter++;
	                  Bridge_SendFault(DTC_SEVERITY_ERROR, DTC_B1031, err_counter, ERR_ACTUATOR_STALL);
	                  HAL_GPIO_WritePin(LED_Error_GPIO_Port, LED_Error_Pin, GPIO_PIN_SET); // Bật LED báo lỗi
	                  rightSent = 1;
	              }
	          } else {
	              rightHolding = 0;
	              rightSent = 0;
	          }

	          if (HAL_GPIO_ReadPin(GPIOE, BTN_WiperMode_Pin) == GPIO_PIN_RESET) {
	              if (!wiperHolding) {
	                  wiperHoldTime = HAL_GetTick();
	                  wiperHolding = 1;
	                  wiperSent = 0;
	              } else if (!wiperSent && (HAL_GetTick() - wiperHoldTime) >= 1500) {
	                  err_counter++;
	                  Bridge_SendFault(DTC_SEVERITY_ERROR, DTC_B1010, err_counter, ERR_WIPER_STALL);
	                  HAL_GPIO_WritePin(LED_Error_GPIO_Port, LED_Error_Pin, GPIO_PIN_SET); // Bật LED báo lỗi
	                  wiperSent = 1;
	              }
	          } else {
	              wiperHolding = 0;
	              wiperSent = 0;
	          }

#if 0
	          if (HAL_GPIO_ReadPin(GPIOB, BTN_Hazard_Pin) == GPIO_PIN_RESET) {
	              if (!hazardHolding) {
	                  hazardHoldTime = HAL_GetTick();
	                  hazardHolding = 1;
	                  hazardSent = 0;
	              } else if (!hazardSent && (HAL_GetTick() - hazardHoldTime) >= 1500) {
	                  err_counter++;
	                  Bridge_SendFault(DTC_SEVERITY_ERROR, DTC_B1030, err_counter, ERR_ACTUATOR_STALL);
	                  HAL_GPIO_WritePin(LED_Error_GPIO_Port, LED_Error_Pin, GPIO_PIN_SET); // Bật LED báo lỗi
	                  hazardSent = 1;
	              }
	          } else {
	              hazardHolding = 0;
	              hazardSent = 0;
	          }
#endif

	          // Quét lỗi kẹt phím Đèn Chiếu Gần (Cos / Low Beam) > 1.5s -> DTC B1001
	          if (HAL_GPIO_ReadPin(GPIOE, BTN_CosLamp_Pin) == GPIO_PIN_RESET) {
	              if (!cosHolding) {
	                  cosHoldTime = HAL_GetTick();
	                  cosHolding = 1;
	                  cosSent = 0;
	              } else if (!cosSent && (HAL_GetTick() - cosHoldTime) >= 1500) {
	                  err_counter++;
	                  Bridge_SendFault(DTC_SEVERITY_ERROR, DTC_B1001, err_counter, ERR_ACTUATOR_STALL);
	                  HAL_GPIO_WritePin(LED_Error_GPIO_Port, LED_Error_Pin, GPIO_PIN_SET);
	                  cosSent = 1;
	              }
	          } else {
	              cosHolding = 0;
	              cosSent = 0;
	          }

	          // Quét lỗi kẹt phím Đèn Chiếu Xa (Pha / High Beam) > 1.5s -> DTC B1002
	          if (HAL_GPIO_ReadPin(GPIOE, BTN_HeadLamp_Pin) == GPIO_PIN_RESET) {
	              if (!headHolding) {
	                  headHoldTime = HAL_GetTick();
	                  headHolding = 1;
	                  headSent = 0;
	              } else if (!headSent && (HAL_GetTick() - headHoldTime) >= 1500) {
	                  err_counter++;
	                  Bridge_SendFault(DTC_SEVERITY_ERROR, DTC_B1002, err_counter, ERR_ACTUATOR_STALL);
	                  HAL_GPIO_WritePin(LED_Error_GPIO_Port, LED_Error_Pin, GPIO_PIN_SET);
	                  headSent = 1;
	              }
	          } else {
	              headHolding = 0;
	              headSent = 0;
	          }

	          // Quét lỗi kẹt phím Đèn Sương Mù (Fog Lamp) > 1.5s -> DTC B1004
	          if (HAL_GPIO_ReadPin(GPIOE, BTN_FogLamp_Pin) == GPIO_PIN_RESET) {
	              if (!fogHolding) {
	                  fogHoldTime = HAL_GetTick();
	                  fogHolding = 1;
	                  fogSent = 0;
	              } else if (!fogSent && (HAL_GetTick() - fogHoldTime) >= 1500) {
	                  err_counter++;
	                  Bridge_SendFault(DTC_SEVERITY_ERROR, DTC_B1004, err_counter, ERR_ACTUATOR_STALL);
	                  HAL_GPIO_WritePin(LED_Error_GPIO_Port, LED_Error_Pin, GPIO_PIN_SET);
	                  fogSent = 1;
	              }
	          } else {
	              fogHolding = 0;
	              fogSent = 0;
	          }

        // 2. Chấp hành các tác vụ phần cứng
        Wiper_Task();
        TurnSignal_Task();
        Headlight_Task();
        Front_BCM_Periodic_TX_Task();



    }
  /* USER CODE END 3 */
}

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
