tumo07/vehicle-dashboard-cluster/(commit log)

2026-09-04 Initial commit: Monorepo structure with CODEOWNERS
    [app.xml]
2026-09-06 Add CAN UART gateway firmware
2026-09-16 Update CAN dictionary: add BLINK_TICK, node IDs, error codes, sensor payload docs; sync translator to new architecture
    [can_messages.h, main.c]
2026-09-16 feat: restructure CAN dictionary v3.0 - Central ECU coordinator architecture with OBD DTCs, banner faults, ACK/NACK, full flow documentation
2026-09-18 Upload source code BluePill Rear BCM hoàn chỉnh
2026-09-18 Upload source code Nucleo F446RE hoàn chỉnh tích hợp CAN V3.0
2026-09-21 build: ignore STM32CubeIDE generated files
2026-09-21 refactor: extract UART protocol module
2026-09-21 refactor: split CAN gateway and UART protocol modules
2026-09-22 Add services, model, controller for uart processing
2026-09-23 feat: add central ECU (F407) and test node (BluePill) with normal CAN config and dedicated debug LEDs
2026-09-23 Fix: Cập nhật Heartbeat 0x720 và sửa lỗi logic ngắt CAN cho Rear BCM
    [main.c]
2026-09-23 docs: update README with full system architecture, flowchart, and v3.0 pivot
2026-09-23 docs: sync README with main (architecture and flowchart)
2026-09-23 Fix: Cập nhật Heartbeat 0x720 và đón lệnh 0x210, 0x211 từ Central ECU
    [main.c]
2026-09-23 Revise README for system architecture clarity
    Updated the README to reflect changes in system architecture and data flow.
2026-09-23 feat(front-bcm): F411+F103 complete overhaul - interrupt-driven CAN RX, stuck button DTC, HIGH_BEAM flag, auto-fog, ADC fix, UART delay fixes
    [Logic_F411.ioc, RX_data_CAN.c, RX_data_CAN.h, RX_data_UART.c, RX_data_UART.h, TX_data_CAN.c, TX_data_CAN.h, TX_data_UART.c]
2026-09-24 feat(central-ecu): add rotary gear selector on pot 2 (P/R/N/D/S) and fix fuel at 85%
    [main.c]
2026-09-24 fix(rear-bcm): comply with coordinator architecture - request trunk via 0x103, act only on 0x211, dynamic open percentage, and reverse sync via 0x300
    [main.c]
2026-09-25 fix(front-bcm): comply with CAN v3.0 coordinator architecture, 0x130 blink tick sync, ISO 26262 fail-safe, and non-blocking UART
    [RX_data_UART.c, RX_data_UART.h, TX_data_UART.c, can_messages.h, headlight.c, main.c, turnsignal.c, wiper.c]
2026-09-30 fix: resolve hardcoded absolute include paths across all STM32CubeIDE projects
    [can_monitor.py]
2026-09-30 feat: add decoders for trunk status and rear BCM sensors
2026-09-30 fix: correct smart spam filter to ignore heartbeat uptime counter
    [can_monitor.py]
2026-09-30 feat: lower smart kick trunk trigger distance from 15cm to 8cm
2026-09-30 fix: correct CAN ID mapping for Trunk (0x303) and Radar (0x304) in monitor script
    [can_monitor.py]
2026-09-30 fix: correct mismatched CAN constants in Front BCM headlight.c and add FRONT_ACT_HIGH_BEAM to headers
    [can_messages.h, headlight.c]
2026-09-30 fix: make CAN monitor completely silent for identical status packets
    [can_monitor.py]
2026-09-30 fix: correct Central ECU headlight mask bitwise accumulation, add F411 diagnostic LEDs
    [main.c]
2026-09-30 fix(front_bcm): enable USART2 NVIC interrupt and IRQHandler on F411, stream 0x130 sync tick from F103
    [RX_data_CAN.c]
2026-09-30 docs: fix Front BCM pinout in project_guide.html (PC1 is ADC Dimmer Pot, PC4/5 are Turn LEDs)
2026-09-30 fix(central_ecu): increase BCM_TIMEOUT_MS to 2500ms to eliminate false-positive watchdog alarms
    [main.c]
2026-09-30 fix: enable local headlight buttons on F411, fix hazard bitmask decode in turnsignal.c, add interactive CAN injector in can_monitor.py
    [can_monitor.py, headlight.c, main.c, turnsignal.c]
2026-09-30 feat(translator_f103): route CAN RX/TX activity debug to onboard user LED PC13
2026-09-30 fix(front_bcm): preserve headlight actuator flags on button events and add PC13 blink to CAN status report
    [TX_data_CAN.c, TX_data_UART.c]
2026-09-30 fix(translator_f103): include main.h in RX_data_CAN.c and update interactive project guide & readme
    [RX_data_CAN.c]
2026-09-30 fix: synchronize dual-node turn signals, fix solid blinker, support gateway TX injection, and filter UART noise faults
    [RX_data_UART.c, can_monitor.py, headlight.c, main.c, turnsignal.c]
2026-09-30 fix(can_monitor): add auto port scanner, periodic heartbeat refresh, verbose mode, and stdout auto-flush
    [can_monitor.py]
2026-09-30 feat(radar): calibrate parking sensor distance thresholds for desktop demo (30cm/20cm/10cm)
2026-09-30 feat(can): centralize turn signal state machine and convert front/rear bcms to pure flash actuators
2026-09-30 fix(cluster): speed up trunk motor, fix front hazard & washer pump, turn off discovery green LED
    [main.c, turnsignal.c, wiper.c]
2026-09-30 fix(front_bcm): revert green debug LED override, preserve light/wiper outputs on LD4
    [main.c]
2026-09-30 fix(wiper): fix AUTO mode logic to default to idle/parked when dry and scale with rain
    [wiper.c]
2026-09-30 fix(wiper): restore rain sensor sensitivity thresholds to last week values (>3000 dry, >2400 light, >1800 medium, <=1800 heavy)
    [wiper.c]
2026-09-30 fix(wiper): restore exact Read_RainSensor_Raw and sensitivity values from last week
    [wiper.c]
2026-09-30 fix(wiper): trigger non-blocking ADC DMA conversion after read to keep rain sensor fresh
    [wiper.c]
2026-09-30 fix(central): update g_veh.wiper_mode from Front BCM 0x400 d[1] so 0x301 byte1 reflects actual wiper state
    [main.c]
